androsaurs/androsaur-stand/references/phone-holder-two-piece/README.md

# Держатель из Body и 82mm

STL переданы владельцем из Загрузок 2026-10-27. Автор, лицензия и исходная
страница пока не сообщены. Размеры трактуются в миллиметрах.

Body: 105,6 × 28,5 × 30 мм. 82mm: 88 × 23,6 × 10 мм.
Оригинальные файлы сохранены без изменений. Детали построены параметрически кодом `../../cadpy/clip_holder.py`
(функции `body()` и `grip()`), форма взята по этим STL; прежние файлы FreeCAD удалены из рабочего дерева, они остались в истории git
(коммит 9d254f3).

Ось Z сборки направлена вдоль Body от нижнего упора вверх, X — поперёк, Y — вперёд к телефону. Поперечина центрирована по ширине
и расположена на Z 66,677–76,677 мм между задними направляющими Body (Z 66,5 и 76,854 мм), по уточняющему изображению владельца.
Физическая фиксация и усилие защёлки не проверены. Верхняя зубчатая деталь по указанию владельца не используется.

Телефонный габарит в модели 170 × 80 × 8,8 мм (`clip_holder.phone()`), нижней кромкой на упоре Body, спинкой к стойке.
