androsaurs/androsaur-stand/references/datasheets/README.md

# Компоненты текущей модели

Используется [MG996R и пользовательский STL](mg996r/README.md).
Не выбранные ранее сервоприводы и неопознанный габаритный серво удалены
из рабочего дерева. Их история сохранена в Git.
