androsaurs/androsaur-stand/references/datasheets/mg996r/README.md

# MG996R: источники и пользовательская модель

`user-model/MG996R_Servo_Model.stl` передан владельцем из Загрузок
2026-10-27 и сохранён без изменений. По нему построен габарит серво в `../../../cadpy/pantilt.py` (функция `servo()`; толщина корпуса уточнена обмером 20 мм).
SHA-256: `99eb0a1ad5ec43cabf3966861050f36cdcc39737a85430847066beaf03012544`.
Автор и лицензия файла не сообщены; автоматически применять к нему
лицензию проекта нельзя. Точный физический экземпляр ещё не обмерен.

`MG996R_Tower-Pro.pdf` — опубликованный паспорт с размерным эскизом,
сохранённый без изменений с
https://www.mysensors.org/dl/57c421ad4d04abe84cd93e17/design/MG996R_Tower-Pro.pdf.
SHA-256: `d925b93e0fcbdba07426cc257e6a4c1dee5bb7f3009138a596c4f7826f548434`.
Условия распространения в документе отдельно не установлены.
Официальная страница: https://towerpro.com.tw/product/mg996r/.
Размеры источников различаются; текущая компоновка основана на переданном STL.
