androsaurs/androsaur-stand/docs/electronics-checks.md

# Проверки электроники перед пайкой

**Коротко: что обязательно, а что только если не заработало.**

- Обязательно: HW-674 выставить на 5,0 В до подключения серво и ESP32 (раздел C); проверить полярность штекера адаптера (E1).
- Платы из коробки обычно работают как есть. PCM5102A (раздел A): сначала подключить и послушать, прозванивать перемычки только если звука нет или он искажён.
- Ключ Q1 (раздел B): проверяется функционально, 3,3 В на PWM включает зарядку.
- Уровень MUTE (раздел D) нужен только если захочется убрать щелчок при включении; MUTE в схеме не подключаем.

Составлено 2026-11-11. Схема: [`schematic.svg`](schematic.svg). Фото и данные плат — в пространстве мета-агента, `notes/electronics-refs/README.md`.
Каждую проверку делать до того, как плата попадёт в схему. Результат записывать в колонку «Результат» в этом файле.

Нужно: мультиметр (прозвонка, проверка диодов, постоянное напряжение), паяльник с оплёткой для снятия припоя, штангенциркуль.
Платы без питания, пока не сказано иное.

## Статус плат

| Плата | В руках? |
| --- | --- |
| PCM5102A (GY-PCM5102) | нет, приедет 2026-11-11 или 2026-11-12 |
| HW-532 (ключ Q1) | да |
| HW-674 (buck), TPA3118, CTP01, адаптер 12 В | уточнить |

## A. PCM5102A (когда приедет)

Сначала: подать 5 В на VIN и GND, BCK, LRCK, DIN от ESP32, выход LROUT на усилитель (тихий тон). Работает, значит остальное в этом разделе не нужно. Не работает или шумит — прозванивать, всё без питания:

Маркировке H/L у перемычек на плате не верить (по отзыву покупателя она перевёрнута). Ориентироваться только на прозвонку.
Режим прозвонки (значок звука): писк или около 0 Ом = соединено.

| № | Что делать | Должно быть | Результат | Если не так |
| --- | --- | --- | --- | --- |
| A1 | Щупы на SCK и GND (в ряду SCK, BCK, DIN, LRCK, GND, VIN) | звонится | | не звонится: припаять провод SCK → GND |
| A2 | XSMT и A3V3 | звонится (звук не заглушён) | | не звонится, а звонится XSMT с GND: перенести паяную перемычку на высокий уровень |
| A3 | FMT и GND | звонится (формат I2S) | | звонится с A3V3: перенести перемычку на GND |
| A4 | FLT и GND | звонится | | перенести перемычку |
| A5 | DEMP и GND | звонится | | перенести перемычку |
| A6 | VIN и A3V3 | **не** звонится (на плате есть стабилизатор) | | звонится: стабилизатора нет, VIN подавать 3,3 В, а не 5 В, и сказать мейн-агенту |

Перемычку переносят паяльником: убрать припой оплёткой с одной стороны площадки и посадить на другую. Потом прозвонить заново.

После того как A1–A6 в порядке, подать 5 В на VIN и GND (от лабораторного блока или шины 5 В стенда) и проверить:

| № | Что | Должно быть | Результат |
| --- | --- | --- | --- |
| A7 | Напряжение A3V3 относительно GND | около 3,3 В | |

## B. HW-532 (ключ Q1), модуль в руках

Подписи на плате (фото владельца): «+» (V+), «LOAD» (середина), «–» (GND). Проверить диодом (значок диода), без питания:

| № | Что делать | Должно быть | Результат |
| --- | --- | --- | --- |
| B1 | Красный щуп на «–», чёрный на LOAD | 0,4–0,7 В | |
| B2 | Красный на LOAD, чёрный на «–» | OL (обрыв) | |
| B3 | «+» относительно «–» и LOAD | не звонится | |

Если B1/B2 показали обратное, подписи на плате неверны: поменять «–» и LOAD местами в схеме и сообщить мейн-агенту.

Затем функциональный тест (нужен адаптер 12 В и модуль CTP01):
1. 12 В на «+» и «–» Q1 (через предохранитель 6,3 А или просто на кратковременное включение).
2. +IN CTP01 на 12 В, –IN CTP01 на LOAD.
3. На PWM и GND Q1 подать 3,3 В от ESP32 (вывод 3V3 и GND платы ESP32) и **заметить**, появилось ли 5 В на USB-A CTP01 (мультиметр на щупах USB).
4. Убрать 3,3 В с PWM: 5 В на USB должно пропасть.

| № | Что | Результат |
| --- | --- | --- |
| B4 | 3,3 В на PWM включает зарядку (5 В на USB есть) — да / нет | |
| B5 | Снять 3,3 В — зарядка выключилась — да / нет | |

Если включается наоборот (без сигнала есть 5 В), в прошивке инвертировать GPIO6. Если не включается совсем, подать 5 В на PWM (в описании модуль рассчитан на широкий диапазон) и сообщить мейн-агенту.

## C. HW-674 (buck 5 В для серво и ESP32)

1. Подать 12 В на IN, **ничего не подключать на выход**.
2. Вращать подстроечник Adj, пока на OUT+ относительно OUT– не будет **5,0 В**.
3. Только потом подключать ESP32 и серво.
4. Сфотографировать плату сверху и крупно маркировку чипа, прислать мейн-агенту (в описании XL4016E1, на фото XL4005).

| № | Что | Результат |
| --- | --- | --- |
| C1 | Выход выставлен на 5,0 В (записать точное значение) | |
| C2 | Маркировка чипа (по фото) | |

## D. TPA3118, уровень MUTE (необязательно)

Нужно только чтобы убрать щелчок при включении через GPIO18. Без MUTE усилитель работает.
Требуется тихий источник звука: телефон с кабелем 3,5 мм.

Громкость источника сначала на минимум. Динамик подключить к OUT+ и OUT–.
1. Подать 12 В на POWER+ и POWER–.
2. Измерить напряжение MUTE относительно GND без соединений: запомнить (0 В или несколько вольт).
3. Подать тихий звук на IN+ (сигнал), IN– на GND, убедиться, что звук идёт.
4. Замкнуть MUTE на GND — звук пропал или остался?
5. Убрать, потом соединить MUTE с 3,3 В от ESP32 — звук пропал или остался?

| № | Что | Результат |
| --- | --- | --- |
| D1 | Напряжение на MUTE без соединений | |
| D2 | MUTE на GND: звук пропал / остался | |
| D3 | MUTE на 3,3 В: звук пропал / остался | |

Вывод: тот уровень, при котором звук пропал, глушит. Результат сообщить мейн-агенту, он допишет схему и логику GPIO18.

## E. Общие и размеры

| № | Что | Результат |
| --- | --- | --- |
| E1 | Полярность штекера адаптера (центр «+») — мультиметром на выходе адаптера | |
| E2 | Напряжение адаптера без нагрузки | |
| E3 | Размеры плат штангенциркулем: TPA3118, PCM5102A, CTP01, HW-674, HW-532, ESP32 (длина, ширина, высота) | |
| E4 | Динамик FD92-1: диаметр окружности отверстий под винты | |

## F. Порядок первого включения (после A–E)

1. Собрать на столе по схеме, **без телефона и без динамика**.
2. Подать 12 В, замерить 5,0 В на шине серво и ESP32, 3,3 В на 3V3 ESP32, 12 В на POWER усилителя.
3. Прошить ESP32 (USB-C), питание 5 В от HW-674 в это время отключить.
4. Проверить серво на малых углах и без механики.
5. Задать в прошивке потолок громкости около 15% полной шкалы PCM5102A **до** первого звука.
6. Подключить динамик, проиграть тихий тон.
7. Подключить телефон через CTP01 и включить Q1.

## G. Собранная подставка: проверка сервоприводов — 2026-11-14

Управление проверено напрямую с компьютера по pinned HTTPS, delegated hub key,
на штатной прошивке `0.7.0-servo-control`. Телефон в командах движения не участвует.

| Проверка | Результат |
| --- | --- |
| Середина: оба канала1500мкс/50Гц на5с | Владелец подтвердил: серво дёрнулось и встало в середину |
| Pan, GPIO4:1475 →1500 →1525 →1500мкс | Владелец подтвердил движение влево-вправо |
| Tilt, GPIO5:1475 →1500 →1525 →1500мкс | Владелец подтвердил движение вверх-вниз |
| Финал | Оба канала получили1500мкс, затем PWM выключен; остановка подтверждена HTTPS |

Каждая команда движения действовала1с; оси проверялись последовательно.
Это подтверждение работы обеих осей в малом диапазоне, не калибровка углов,
крайних положений, направлений знака или способности питания выдерживать упор.
Границы1450..1550мкс пока ограничивают ручное управление; автослежение выключено.
Выход HW-674 мультиметром и физическое переключение зарядки в этом прогоне
не проверялись; строки предыдущих таблиц не считать автоматически заполненными.

## Расхождения с electronics.md

[`electronics.md`](electronics.md) пока не обновлён: там питание PCM5102A 3,3 В (на самом деле 5 В на VIN, по схеме macsbug), серво и ESP32 раздельные ступени (решение владельца 2026-11-11: общий buck 5 В), подстроечный резистор и резисторы 220 Ом на сигнале серво (убраны), блока питания 6 В нет (серво на 5 В).
