androsaurs/androsaur-stand/docs/electronics.md

# Электроника

Состав, питание и подключение. Размеры плат в модели оценочные (по фото продавцов), кроме габаритов; перед печатью их надо
перемерить штангенциркулем и поправить в [`cadpy/amp.py`](../cadpy/amp.py), [`esp32.py`](../cadpy/esp32.py), [`speaker.py`](../cadpy/speaker.py).

| Узел | Выбор | Примечание |
| --- | --- | --- |
| Контроллер | ESP32-S3 N16R8 DevKitC-1 WROOM-1, плата 28 × 57, с антенной 64 мм | Два USB-C. На модуле с PSRAM октал заняты GPIO35–37 |
| Динамик | FD92-1, 4 Ом, 10 Вт, фланец Ø92, магнит Ø50 × 22, высота 42, диффузор Ø75 | Четыре отверстия Ø4 во фланце; диаметр их окружности (82 мм) принят, не измерен |
| ЦАП | PCM5102A, плата 17 × 32, выход на разъём 3,5 мм | I2S от ESP32, питание 3,3 В |
| Усилитель | Моно TPA3118, плата 46,5 × 35, четыре отверстия | Вход аналоговый, есть вход MUTE |
| Серво | 2 × MG996R 180° | 4,8–7,2 В, до 2,5 А каждый при упоре |
| Блок питания (buck 6 В) | Куплен; в описании продавца «XL4016E1, вход 4–38 В, выход 1,25–37 В, 8 А», на фото модуль HW-674 (маркировка XL4005) 60 × 38 × 26 | Какой чип на самом деле, пока не известно (описание и фото расходятся). Модель сделана по фото. Выход настроить на 6,0 В мультиметром до подключения серво |

## Питание

Один адаптер 12 В 5–6 А (штекер 5,5 × 2,1), дальше отдельные ступени:

```
Адаптер 12 В ──[предохранитель 6,3 А]──┬── усилитель TPA3118 (12 В напрямую)
                                        ├── buck 6 В ≥ 5 А ── два MG996R
                                        ├── buck 5 В 3 А ──── ESP32 (5V); от её 3V3 питается ЦАП
                                        └── зарядка 5 В 2–3 А ─ USB для телефона
```

Земли сводятся в одной точке. Питание серво отдельным преобразователем, иначе броски тока портят звук и перезагружают ESP32.

Бюджет (пик, оценка): серво до 30 Вт, усилитель около 13 Вт при 10 Вт на выходе, ESP32 с ЦАП около 2 Вт, зарядка телефона около 11 Вт.
Итого до 57 Вт при одновременном упоре обоих серво; на практике хватает 12 В 5 А.

Что искать в магазине:

- Блок питания «12 В 5 А 60 Вт, 5,5 × 2,1»; смотреть отзывы, реальная мощность часто занижена.
- Buck на серво: «DC-DC понижающий XL4015 5A CC/CV», выход настраивается, лучше с радиатором. LM2596 на 3 А мало.
  Модуль на XL4005 (HW-674, 60 × 38 × 26) без ограничения тока и тесный по высоте; XL4016 (65 × 47 × 23,5) в корпус не помещается.
- Buck на ESP32: «MP1584EN 3A».
- Зарядка телефона: «понижающий 12 В → 5 В 3 А с USB» или модуль USB-C PD с входом 12 В.
- Мелочи: предохранитель, электролит 1000 мкФ на 10–16 В на шине серво, панельное гнездо 5,5 × 2,1, разъёмы JST/XT30.
- Выход buck на серво настроить мультиметром на 6,0 В **до подключения серво**, MG996R выше 7,2 В выходит из строя.

## Усилитель и ЦАП: громкость обязательно ограничить

PCM5102A на полной шкале даёт около 2 В действующего значения, усилитель без регулировки усиливает примерно в 20 раз.
До 10 Вт на 4 Ом хватает входа около 0,3 В. Значит:

- потолок громкости в прошивке около **15% полной шкалы** (примерно −16 дБ), точное значение подобрать на слух и мультиметром;
- на полной шкале усилитель уходит в клиппинг и отдаёт динамику больше 10 Вт, динамик это не переживёт;
- на вход усилителя рекомендуется поставить делитель из двух резисторов или подстроечный резистор, чтобы защита не зависела от прошивки;
- питать усилитель выше 12 В нельзя, динамик 10 Вт.

Подключение PCM5102A: SCK замкнуть на землю (на многих платах перемычка на обратной стороне; сверить с описанием продавца),
выводы BCK, DIN, LCK — линии I2S ESP32. Сигнал на усилитель с гнезда 3,5 мм или с площадок L/G, моно: левый канал.
MUTE усилителя — на ногу ESP32, чтобы глушить усилитель при включении (нет щелчков).

## Управление серво

- ШИМ 50 Гц, импульс 500–2500 мкс на 0–180°. Аппаратный ШИМ (LEDC), две свободные ноги (например GPIO4 и 5), не 0, 3, 45, 46 и не 35–37.
- Сигнал 3,3 В MG996R обычно принимает; при сбоях — преобразователь уровней. Резистор 220–470 Ом последовательно.
- Серво не знают своего положения: при включении подавать последнее известное положение или плавно подводить.
  Движение с разгоном и торможением, чтобы не просаживать питание.
- Углы по модели: наклон −2…100°, поворот 180°.
- Провода идут через полость ножки и два окна на фасаде ножки (зарядка и моторы).

## Что не решено

USB ESP32 находится внутри закрытого корпуса (прошивка — со снятой верхней половиной), антенна смотрит в стенку корпуса,
рядом блок питания и усилитель: возможны помехи. См. [open-issues.md](open-issues.md).
