androsaurs/androsaur-stand/docs/project-organization.md

# Организация моделей

Актуальная структура после перехода на детали BRep, 2026-11-02. В рабочем дереве одна конструкция.

```text
cad/
├── components/                 # покупные изделия и габариты
│   ├── mg996r-brep/mg996r-brep.FCStd  # BRep-габарит, один источник, два экземпляра
│   ├── mg996r/mg996r.FCStd      # пользовательская сетка: источник и эталон для BRep
│   └── phone/phone.FCStd
├── parts/                      # изготовляемые детали
│   ├── base/base.FCStd
│   ├── pan-carrier-brep/pan-carrier-brep.FCStd
│   ├── servo-side-brep/servo-side-brep.FCStd
│   ├── shaft-side-brep/shaft-side-brep.FCStd
│   ├── tilt-platform-brep/tilt-platform-brep.FCStd
│   ├── tilt-horn/tilt-horn.FCStd
│   ├── pan-horn/pan-horn.FCStd
│   ├── phone-holder/phone-holder.FCStd
│   └── phone-holder-body, phone-grip-82mm, phone-adapter-plate   # держатель из двух деталей
└── assemblies/
    ├── pan-tilt-brep.FCStd      # механизм
    ├── phone-holder.FCStd       # держатель и телефон
    ├── phone-holder-two-piece.FCStd  # держатель из двух деталей (в stand не установлен)
    └── stand.FCStd              # общая компоновка
exports/                        # снимки для обмена и изготовления
references/                     # оригиналы сторонних материалов
docs/                           # текущая документация
scripts/                        # проверка и построение (build-*.FCMacro)
```

Деталь — один документ. Геометрию редактировать в нём. Покупное изделие
использовать через повторные App::Link; оба MG996R ссылаются на один объект.
Верхняя площадка — одна деталь; внутри её документа сохранены четыре
геометрических элемента, уже в принятых относительных положениях.

Подсборка — отдельный документ с корневым App::Part `Module`. Он содержит
ссылки на детали и именованные опорные системы координат. Подсборку можно
открывать, изучать и изменять независимо. Внешние модули не зависят от неё
геометрией: связь идёт через опорный интерфейс.

Общая stand.FCStd содержит только экземпляры модулей. PhoneHolder.Placement
вычисляется через `PanTilt.Placement * PanTilt.PhoneInterface`. Поэтому держатель
следует за механизмом, а перенос всей подставки не требует двигать каждую деталь.

Корпус электроники пока не спроектирован. Для него создать отдельные детали
в parts/ и сборку electronics-case.FCStd с корневым Module и MountInterface.
Затем добавить ссылку в stand.FCStd и совместить интерфейс корпуса с
BaseInterface механизма. До этого пустые заготовки и условные объёмы не добавлять.

Старые варианты и промежуточные экспорты удалены. История — Git,
`before-modular-layout`, а не каталоги old/final/v2. Экспорты не являются источником
геометрии и обновляются после изменения FCStd. Проверенный печатный комплект
пока не выпускался.

Замена 2026-11-02: сеточный механизм `pan-tilt.FCStd` и сеточные детали заменены на BRep
(`docs/pan-tilt-brep.md`). Старое состояние — коммит `a86b0bd` в Git. Эксперименты по превращению
STL в BRep перенесены вне репозитория в `/mnt/fastdata/hram/archive/androsaur-stand-brep-experiments-20261102`.
