androsaurs/androsaur-stand/references/pan-tilt-1941574/README.md

# Pan and Tilt for Standard Servo — 1941574

Архив передан владельцем 2026-10-26 из Загрузок, сохранён без изменений.
Автор: micromet. Источник по README архива:
https://www.thingiverse.com/thing:1941574.
Лицензия по LICENSE.txt: Creative Commons Attribution Share Alike;
версия в приложенном тексте не указана. Сторонние материалы сохраняют
собственные условия, лицензия Androsaur Stand их не заменяет.

SHA-256 архива: `7ca2dae743f5629b68f92221c4c787d6d7f99939f9b440355d1fad99935869af`.
`original/` — используемые материалы распакованного архива; `scad-rev/` —
используемые исходники из вложенного `PanTilt_std_SCAD_rev.zip`.
Неиспользуемый держатель ИК-датчика удалён из распакованного дерева;
полный оригинальный ZIP сохранён. Оставшиеся STL и SCAD не изменялись.

Авторские фотографии: original/images/Assem1.jpg, Assem2.jpg, explod.jpg.
Исходники указывают HobbyKing15269. Принятая владельцем компоновка с MG996R
собрана кодом в `../../cadpy/`; реальные посадки и крепёж
ещё не проверены. Геометрия автора и производные сохраняют его CC BY-SA.
