androsaurs/androsaur-stand/docs/requirements.md

# Требования

Актуализировано по указаниям владельца, 2026-11-04. Принятые ранее положения о механизме сохранены.

## Подставка

- Два серво MG996R 180° (поворот и наклон), по STL владельца (габарит, не обмеренный экземпляр).
- Телефон Xiaomi Redmi 12 без чехла: 168,6 × 76,3 × 9,0 мм (толщина по замеру владельца), ось наклона посередине высоты. Двухдетальный держатель (спинка + захват 77,3 мм между стенками).
- Кнопки телефона на правой боковой грани, на высоте около 85 мм от нижнего края (замер владельца, нижний край нижней кнопки не уточнён). Захват держит телефон на высоте 59,7–69,7 мм от нижнего края: центр кнопок вне зоны захвата; если нижняя кнопка начинается ниже 70 мм, нужно окно в боковой стенке захвата.
- Зарядка Type-C снизу: место под штекер и кабель, не упирается в основание при наклоне вперёд. Ножка достаточно высокая
  (104 мм), чтобы кабель дошёл до окна на ножке.
- Ножка полая для проводов, два окна со стороны телефона (зарядка и моторы).
- Основание **не стоит на корпусе, а висит под крышкой**, ножка выходит вверх через отверстие в крышке. В верхней стороне
  крышки нет отверстий под винты подставки.

## Корпус

- Размер 125 × 125 мм (высота выбрана 70), **разборный из двух частей**, шов горизонтальный посередине, винты снизу.
- Содержимое: динамик FD92-1 (4 Ом, 10 Вт), ESP32-S3, усилитель, ЦАП, блок питания, питание и зарядка телефона.
- Динамик в углу корпуса, на проставках над дном, в полу решётка. Внутри полка на ножках с отверстием под магнит динамика.
- Полка с плоским верхом: печатается плитой вниз; платы на ней и под ней.
- Вход питания на задней стенке нижней половины, вентиляция на задних стенках обеих половин, щели в полке напротив для сквозной тяги.
- Корпус на отдельных ножках, которые крепятся к нему отдельно и не входят в деталь корпуса.
- Ножки корпуса не у самого края, симметрично.

## Электроника и питание

- Адаптер питания 12 В, гнездо 5,5 × 2,1 мм (владелец купил адаптер).
- Усилитель на 10–20 Вт, питание 8–24 В, цифровой звук с ESP32 по I2S через ЦАП (куплены PCM5102A и TPA3118 мономодуль).
- Серво питаются отдельным понижающим преобразователем на 6 В.
- Блок питания: подходящий модуль не выбран; в корпусе должно быть место, габарит ~51 × 26 × 14 мм (XL4015) подходит.

## Изготовление

- Пробная печать PLA на Flying Bear Ghost6, **без поддержек** там, где это возможно.
- Проверка пересечений в диапазоне движения (наклон −2…100°, поворот) — обязательная при любом изменении геометрии.
