androsaurs/androsaur-stand/docs/fasteners.md

# Крепёж

Номенклатура: три длины M3 (6, 8 и 12 мм) и один M4 (динамик). Винты из комплекта серво не используются: отверстия под них в
лотке и в площадке переделаны под M3. Длины проверены по модели: глубина отверстий, вход в пластик, головка в углублении.
Резьба нарезается самим винтом в отверстия Ø2,6 (PLA); для частой разборки можно поставить латунные вставки M3 (диаметр отверстий
придётся увеличить до 4–4,2 мм).

Головка круглая или полукруглая (ISO 7380 Ø5,7, DIN 7985 Ø5,6, DIN 912 Ø5,5): она должна проходить в углубления Ø6,4.

| Узел | Шт | Крепёж | Как работает |
| --- | --- | --- | --- |
| Усилитель к стойкам под полкой | 4 | M3×6 | Через плату в пилоты стоек, винт заходит на 4,4 мм |
| Ножки полки | 3 | M3×6 | Снизу через дно, головка в углублении Ø6,4 × 2,5 мм, в ножку входит 4,5 мм |
| Ножки корпуса | 4 | M3×6 | Изнутри в углублении Ø6,4 × 2,5 мм через пол в пилот ножки, входит 4,5 мм |
| Подошва подставки к крышке | 4 | M3×8 (ISO 7380) + печатная прижимная шайба | Головка снизу под шайбой толщиной 3 мм; винт входит в глухой пилот пенька на 5 мм, до дна остаётся 1 мм |
| Стяжка половин корпуса | 4 | M3×12 | Снизу в тоннель Ø6,4 глубиной 31 мм в нижней стойке, в пилот верхней стойки входит 8 мм |
| Спинка держателя к площадке | 4 | M3×8 | Со стороны телефона: головка в углублении Ø6,4 × 3 мм спинки, винт входит в глухой пилот Ø2,6 × 4,5 мм площадки (плита 6 мм), 4 мм в зацеплении; гаек нет. Телефон надо вынуть, чтобы добраться до головок |
| Нижнее серво к лотку | 4 | M3×8 | Снизу вверх через ухо серво (Ø4,2) в пилот Ø2,6 лотка, входит 5 мм, конец не выходит над плитой |
| Верхнее серво к площадке | 3 | M3×8 | С верха уха серво в блок площадки (пилот Ø2,6 вдоль оси Y), входит 5 мм; в четвёртом углу под ухом нет материала (низкий блок), там винта нет |
| Боковины к лотку | 4 | M3×8 | Через отверстие Ø3 боковины в отверстие Ø2,6 лотка, входит 5 мм |
| Блок питания HW-674 к полке | 4 | M3×8 | Сверху: головка на плате, под ней печатная втулка 3 мм, дальше плита полки 3 мм и столбик под ней 2,5 мм; входит 3,4 мм, конец остаётся в столбике |
| Динамик во фланец | 4 | M4×8 | Сверху через фланец в стойки Ø9 × 5 с пилотом Ø3,4; при отверстиях во фланце Ø4,0 — M3,5×8 |

## Что купить

С запасом около 25%:

| Позиция | Нужно | Купить |
| --- | --- | --- |
| M3×6 | 11 | 15 |
| M3×8 | 23 | 30 |
| M3×12 | 4 | 6 |
| M4×8 (или M3,5×8) | 4 | 6 |

Для крепления подставки напечатать **4 шайбы `stand_washer` Ø18 × 3 мм**:
сквозное отверстие Ø3,4, выборка Ø9,8 × 0,5 мм на стороне подошвы. Шайба перекрывает
отверстие подошвы Ø9,4; выборка даёт 0,5 мм до торца пенька, чтобы затяжка прижимала
подошву. Плоская сторона шайбы обращена к головке винта, выборка — к `base`.
Печатать плоской стороной на стол, без поддержек; требуется 4 экземпляра одного STL.

Сборочные координаты: шайбы Z2–5, подошва Z5–9, головки винтов Z0,35–2, стержни Z2–10.
Вход в пеньки начинается на Z5, дно пилотов — Z11. Это винты в прежние пилоты Ø2,6,
с самонарезанием резьбы в PLA, а не сквозное соединение с гайками. Упрощённый стержень Ø3
в модели пересекает пилот Ø2,6 на 8,264 мм³ для каждого винта — это ожидаемый объём резьбового зацепления.

## Что не определено

- Качалки серво (круглая и на верхнем серво) и их крепёж из комплекта серво в модели не размещены.
- Положение крепёжных отверстий блока питания HW-674 (принято: отступ 3,5 мм от углов), измерить на плате. Печатные втулки 3 мм (4 шт) входят в крепление.
- Диаметр отверстий во фланце динамика (принят Ø4,0, нужно измерить): от него зависит M4 или M3,5.

## Почему не одна длина

Для подставки M3×8 даёт 5 мм захода после шайбы 3 мм. M3×6 дал бы 3 мм захода,
а M3×10 потребовал бы 7 мм при глубине пилота 6 мм и упёрся бы в дно. Поэтому выбран M3×8.
Стяжка корпуса проходит через 31 мм тоннеля и заходит в пилот на 8 мм, ей нужен M3×12.
