androsaurs/androsaur-stand/docs/interfaces.md

# Системы координат и опорные точки

Единицы — мм. **Мировая система модели:** Z вверх, фасад (сторона телефона) +X, ось наклона вдоль Y.
Начало (0, 0, 0) сохраняет исходную систему сборки; после подгонки к крышке низ подошвы находится на Z5.
Ось ножки — в точке (42,5; 42,5), верх цилиндра остаётся на Z104.

| Что | Положение |
| --- | --- |
| Низ подошвы подставки | z = 5 |
| Верх подошвы | z = 9 |
| Торцы четырёх пеньков крышки | z = 5 |
| Низ потолка корпуса | z = 9 |
| Верх крышки | z = 12 |
| Шов между половинами | z = −23 |
| Низ корпуса | z = −58 |
| Низ ножек корпуса | z = −66 |

Корпус `enclosure.py` строится в собственной системе (начало в центре корпуса по X и Y, Z от низа дна), а в сборке ставится сдвигом
`Pos(42,5; 42,5; −58)` (см. `to_box` в `assemble`). Там же сказано, где какая сторона.
Положение корпуса фиксируется `BOX_Z0`, поэтому изменение толщины потолка не перемещает корпус и его содержимое.
`BASE_Z0` вычисляется по низу потолка: подошва Z5–9 прилегает к крышке на Z9, пеньки Z5–9 входят в неё на все 4 мм.
Цилиндр укорочен снизу с 104 до 99 мм; высоты его верха, окон, посадки серво и механизма не изменились.

## Платформа и телефон

Система платформы: `x_p` вдоль высоты телефона, `y_p` поперёк и вдоль оси наклона, `z_p` — толщина; телефон со стороны −`z_p`.
Наклон 0° — площадка горизонтально лицом вверх; 90° — вертикально лицом к +X; больше 90° — наклон вперёд. Ось наклона проходит
по середине высоты телефона, за ним, а не внутри толщины. Ось поворота — вертикальная ось ножки.

## Держатель

Держатель строится в системе X поперёк телефона, Y к телефону, Z вдоль высоты и ставится на платформу `Location(Plane(...))` в
`assemble`. Задняя плоскость спинки прилегает к площадке; `HOLDER_SLIDE = −8` сдвигает его вдоль высоты телефона.

## Подсборки

Всё собирается кодом: `assemble()` кладёт каждую деталь по явным координатам. Новые модули добавлять новой функцией и
ставить на корпус или на основание по этим координатам.
