androsaurs/androsaur-stand/docs/pan-tilt-brep.md

# Механизм на деталях BRep (pan-tilt-brep)

`cad/assemblies/pan-tilt-brep.FCStd` — поворотно-наклонный механизм общей сборки. С 2026-11-02 он
заменил сеточный `pan-tilt.FCStd`: четыре детали micromet / Thingiverse 1941574 построены в BRep по SCAD
из архива, серво MG996R заменено BRep-габаритом. `stand.FCStd` ссылается на этот модуль, положения
механизма и держателя при переключении не изменились (разница 0,000000). Старое состояние — коммит `a86b0bd`.

## Состав

| Деталь | Файл | Источник |
| --- | --- | --- |
| Крепление нижнего серво | parts/pan-carrier-brep | PanMount7.scad |
| Боковина со стороны качалки | parts/servo-side-brep | sideplateservo_std.scad |
| Боковина с выступом | parts/shaft-side-brep | sideplateshaft_std.scad |
| Площадка наклона | parts/tilt-platform-brep | tiltservomount_std.scad |
| Серво MG996R (2 экземпляра) | components/mg996r-brep | замеры components/mg996r |

Без изменений из прежней модели: `base` (удлинённая полая ножка), `pan-horn`, `tilt-horn`. Площадка ИК-датчика
не включена. Структура модуля: `Module`, группы Fixed/Pan/Tilt, `BaseInterface`, `PhoneInterface`.
Детали строят `scripts/build-brep-parts.FCMacro` и `scripts/build-mg996r-brep.FCMacro`;
существующие файлы они не перезаписывают.

## Допущения

- Блоки серво площадки, их рёбра и отверстия под уши сдвинуты на 1,3151 мм вдоль оси Y площадки
  (`SERVO_MOUNT_SHIFT_Y`). Это принятая подгонка под MG996R: нижняя грань ушей серво лежит на y = −10,697 мм,
  грань блока — на −10,685 мм. Какие элементы SCAD входят в сдвигаемую группу, выбрано по смыслу.
- Положения серво взяты из принятой модели без изменений.
- Сетка MG996R несвязная (107 компонентов, самопересечения), у ушей открытые пазы вместо отверстий.
  BRep-габарит: корпус 19×40, уши 54×2,5 с отверстиями Ø4 (шаг 49,5×10), бобышка Ø13, шлиц Ø5,6, кабель Ø3.
  Не моделируются рёбра на ушах, штырёк 3×4, кольцо вокруг кабеля, углубления крышки.
  Положение отверстий — номинальная схема MG996R, не измерение.

## Проверено (расчёт во FreeCAD)

- Объёмы деталей совпадают с экспериментальной сборкой до 0,001 мм³; тела валидны, по одному solid.
- Положения всех девяти ссылок и групп совпали с принятой моделью (0,000000 мм, 0,000000°).
- BRep-габарит серво: 321 из 361 вершины сетки вне него лежат в пределах 0,05 мм, остальные до 0,3 мм, кроме
  пропущенных кольца кабеля (до 1,0 мм) и штырька (0,31 мм). Обратное направление (где BRep выступает
  за сетку) не измерялось.
- Нижнее серво: ошибка отверстий лотка 0,005 мм, ось вала на 0,015 мм от оси лотка.
- Верхнее серво: ошибки отверстий блоков 0,094 и 0,434 мм (шаг 49,5 мм против 49 мм), уши отстоят от грани
  блока на 0,012 мм, вал смещён от оси штифта на 0,46 мм.
- Пересечения, 7 деталей BRep, 21 пара: нет. Касания: Base–качалка, лоток–боковины.
- Пересечения серво: верхнее — нет (платформа 0,012 мм, ServoSide 0,003 мм, вставка 0,14 мм).
  **Нижнее входит в потолок кармана лотка: 257 мм³ по BRep (верхняя оценка, крышка в BRep сплошная),
  по сетке до 0,7 мм.** Причина: корпус MG996R выше стандартного серво примерно на 0,8 мм, карман лотка
  заканчивается на z = 8,0 мм. Лоток не менялся, решение за владельцем.
- Движение, пересечений нет: поворот −90°, −45°, 0°, +45°, +90° при нулевом наклоне; наклон −30°, −15°, 0°,
  +15°, +30° при нулевом повороте. Зазор платформы до корпуса нижнего серво: 18,4 мм при −30°, 10,0 мм при 0°,
  **1,69 мм при +30°** (дальше столкновение вероятно, предел не искали). До Base при +30° — 29,8 мм.

## Не проверено

- Сочетания поворота и наклона, точные пределы наклона, держатель с телефоном в движении.
- Путь кабеля, шлицы, крепёж, нагрузки, печать.
- Поведение BRep-серво по отношению к исходной сетке там, где BRep выступает за неё.
