androsaurs/androsaur-stand/docs/img/mechanism-tilt0.png

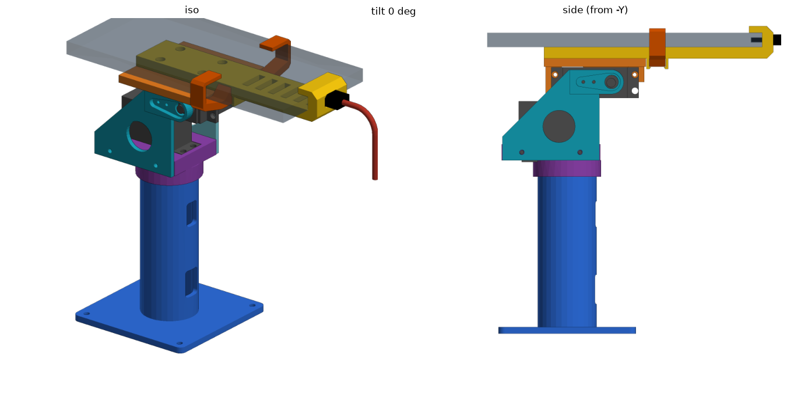
docs/img/mechanism-tilt0.png
