androsaurs/androsaur-stand/docs/img/mechanism-tilt45.png

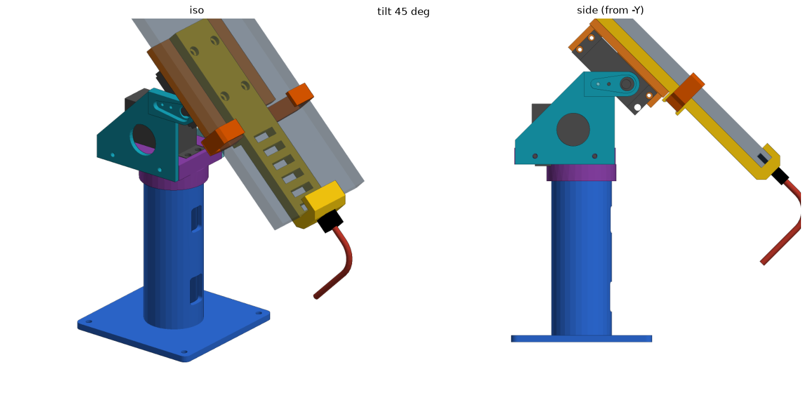
docs/img/mechanism-tilt45.png
