androsaurs/androsaur-stand/docs/img/power-jack-drawing.png

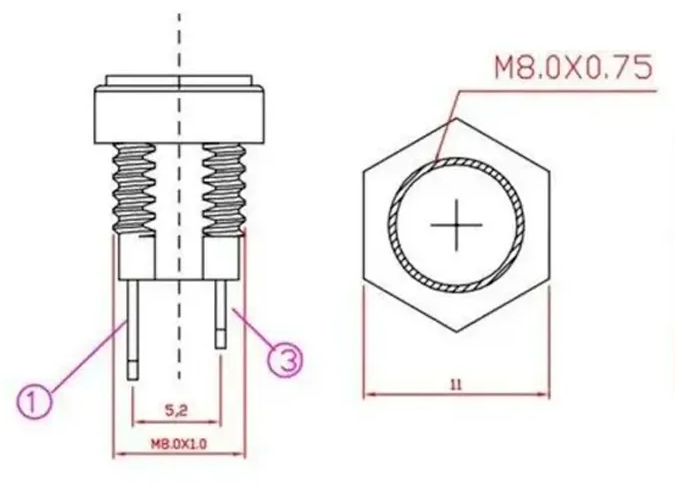
docs/img/power-jack-drawing.png
