androsaurs/androsaur-stand/references/1941574-fresh-20261027/images/834c1b2ab8570df11cbdad39efb2c1d5.png

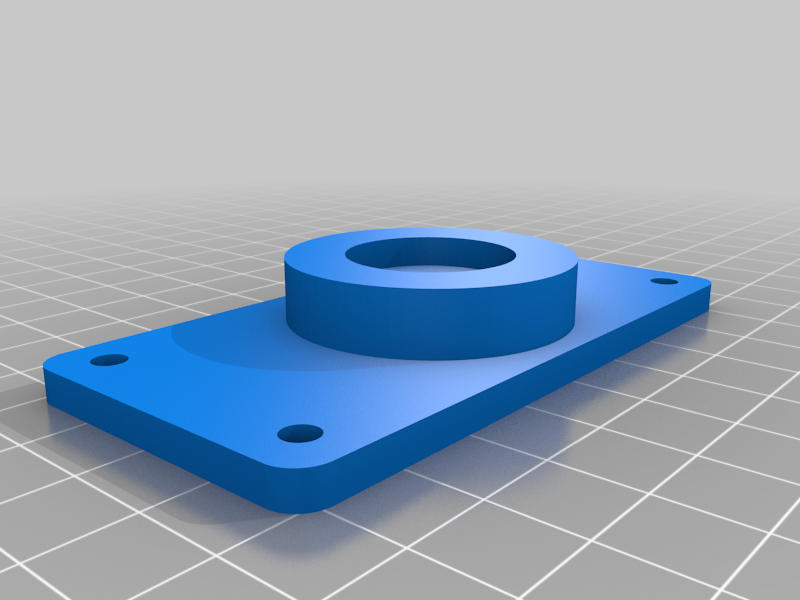
references/1941574-fresh-20261027/images/834c1b2ab8570df11cbdad39efb2c1d5.png
