androsaurs/androsaur-stand/references/1941574-fresh-20261027/images/878f043e9cf753a4e5998eb0beb1df78.png

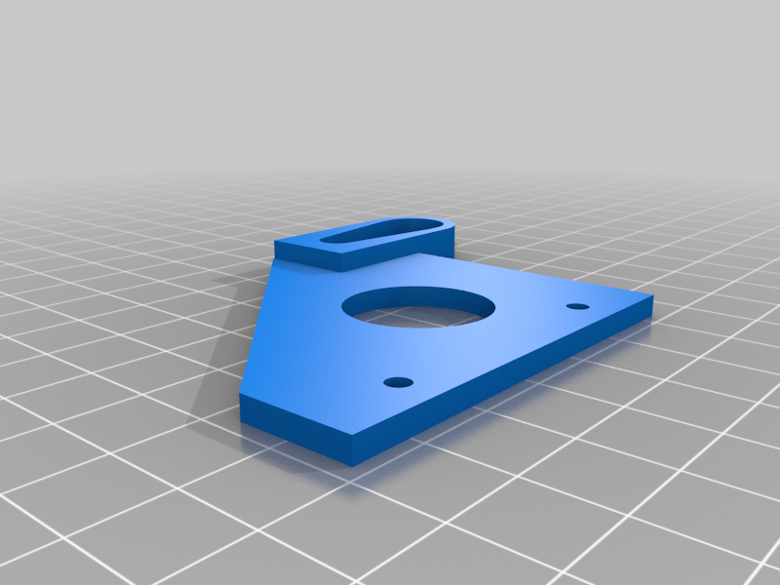
references/1941574-fresh-20261027/images/878f043e9cf753a4e5998eb0beb1df78.png
