androsaurs/androsaur-stand/references/1941574-fresh-20261027/images/520617ca388473ef5005c774b7b16fb1.png

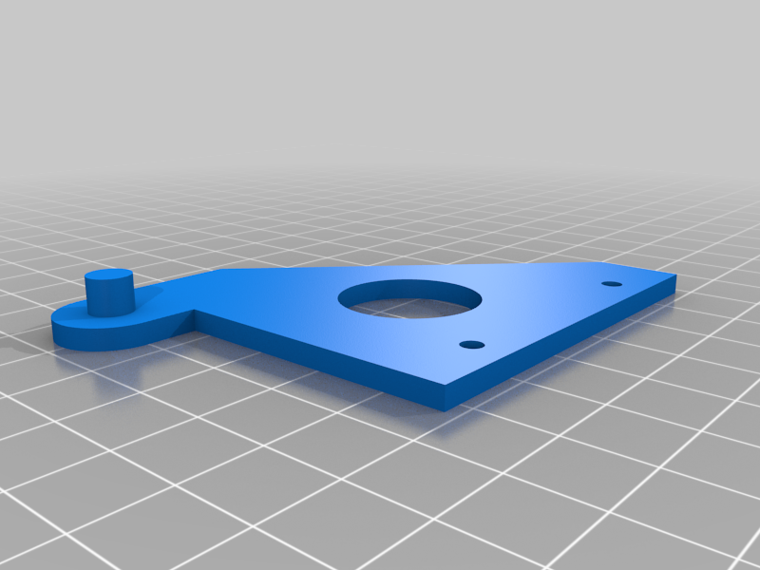
references/1941574-fresh-20261027/images/520617ca388473ef5005c774b7b16fb1.png
