androsaurs/androsaur-stand/references/1941574-fresh-20261027/images/18764812d7d0b451ea0a2450d63cde3c.png

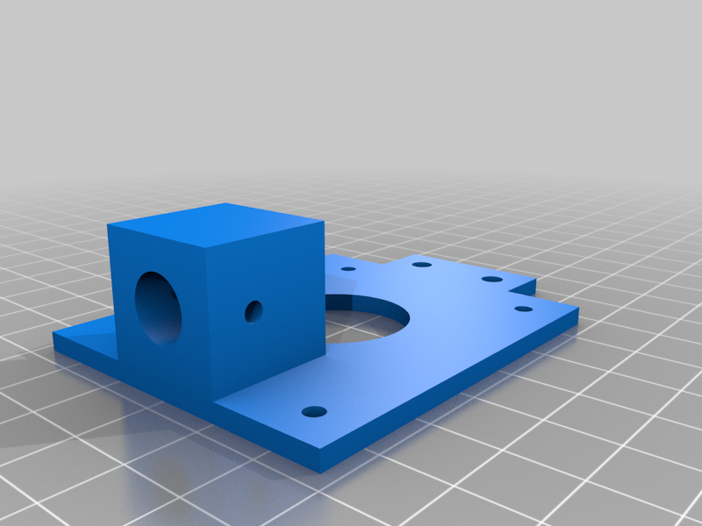
references/1941574-fresh-20261027/images/18764812d7d0b451ea0a2450d63cde3c.png
