androsaurs/androsaur-stand/references/1941574-fresh-20261027/images/Assem1.jpg

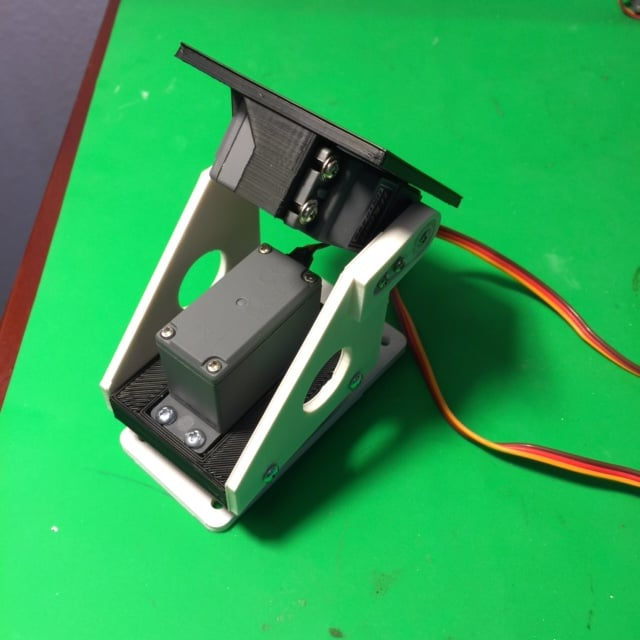
references/1941574-fresh-20261027/images/Assem1.jpg
