androsaurs/androsaur-stand/references/1941574-fresh-20261027/images/cccd069f99a9c03c0258334f676bf5a1.png

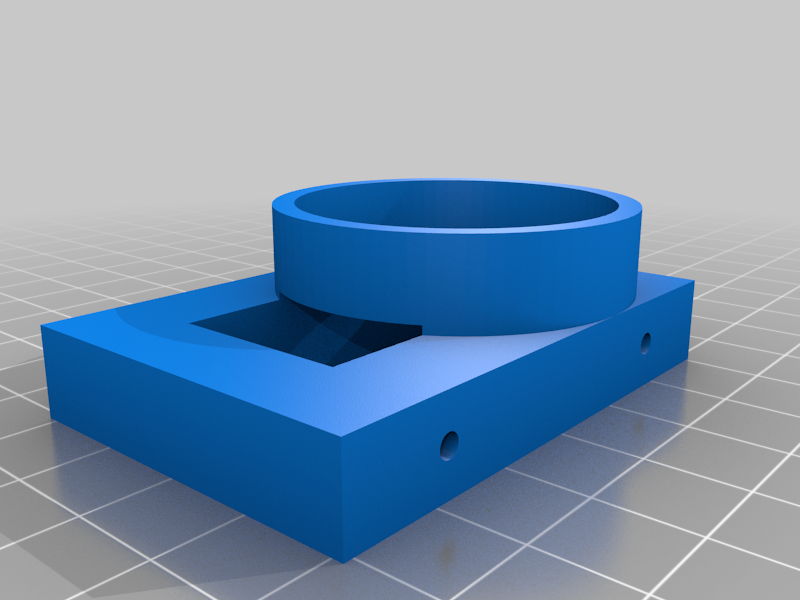
references/1941574-fresh-20261027/images/cccd069f99a9c03c0258334f676bf5a1.png
