androsaurs/androsaur-stand/references/1941574-fresh-20261027/images/ec95f7fee5eaacb880e60dee57f20235.png

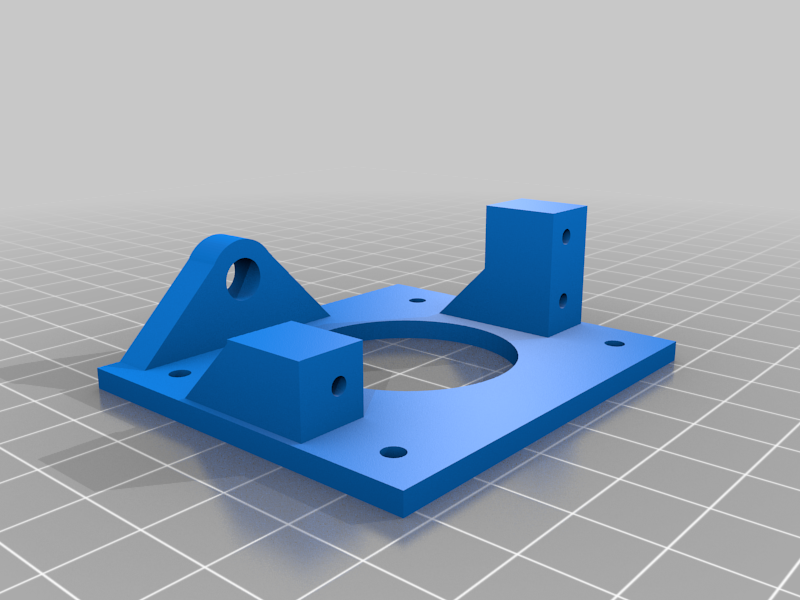
references/1941574-fresh-20261027/images/ec95f7fee5eaacb880e60dee57f20235.png
