androsaurs/androsaur-stand/references/1941574-fresh-20261027/images/explod.jpg

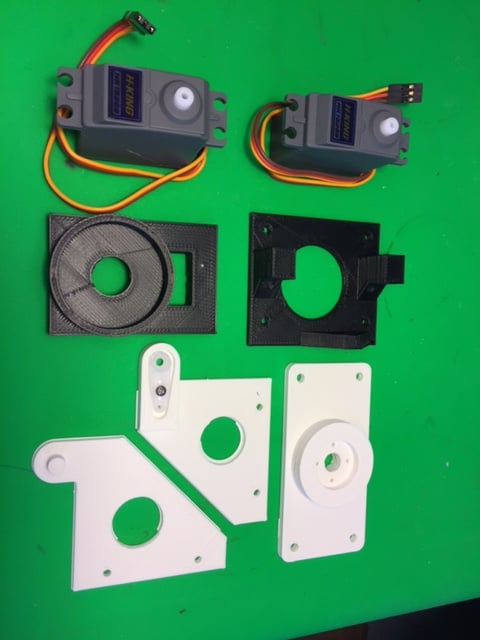
references/1941574-fresh-20261027/images/explod.jpg
