androsaurs/androsaur-stand/docs/bom.csv

part_id | quantity | kind | status | notes
base | 1 | printed | model | подошва 85x85, ножка Ø36,4, полость
stand_washer | 4 | printed | model | прижимные шайбы Ø18x3, отверстие Ø3,4, выборка Ø9,8x0,5 со стороны base
carrier | 1 | printed | model | лоток нижнего серво
plate_horn | 1 | printed | model | боковина со стороны качалки
plate_shaft | 1 | printed | model | боковина с выступом
platform | 1 | printed | model | площадка наклона, 5 мм со стороны держателя
body | 1 | printed | model | спинка держателя
grip | 1 | printed | model | захват 82 мм
box_lower | 1 | printed | model | нижняя половина корпуса, дном вниз
box_upper | 1 | printed | model | верхняя половина, потолком вниз
shelf | 1 | printed | model | полка, плитой вниз, верх плоский
foot | 4 | printed | model | ножки корпуса Ø14x8, винт M3 изнутри
втулка под блок питания 3 мм | 4 | printed | model | Ø7 x 3, отверстие Ø3,4
MG996R | 2 | purchased | chosen | серво 180°, габарит по STL владельца
FD92-1 | 1 | purchased | chosen | динамик 4 Ом 10 Вт, фланец Ø92, магнит Ø50x22, высота 42
ESP32-S3 N16R8 DevKitC-1 | 1 | purchased | chosen | плата 28x57, антенна до 64
PCM5102A | 1 | purchased | chosen | ЦАП, плата 17x32, I2S
TPA3118 моно | 1 | purchased | chosen | усилитель, плата 46,5x35, питание 8-24 В
адаптер 12 В 5-6 А, 5,5x2,1 | 1 | purchased | chosen | владелец купил
гнездо питания 5,5x2,1 панельное | 1 | purchased | bought | по чертежу резьба M8x0,75 (на чертеже и M8x1,0), гайка шестигранная 11 мм под ключ, два вывода (1 и 3) через 5,2 мм; по замеру владельца резьба Ø7,6; отверстие в стенке Ø8,0; чертёж docs/img/power-jack-drawing.png
buck 6 В XL4005 HW-674 (куплен) | 1 | purchased | chosen | 60x38x26, питание серво; реально 3-4 А, без ограничения тока
buck 5 В 3 А (MP1584EN) | 1 | purchased | not-chosen | питание ESP32
зарядка телефона 5 В 2-3 А | 1 | purchased | not-chosen | USB от 12 В
предохранитель 5 А и 6,3 А | 2 | purchased | not-chosen
электролит 1000 мкФ 10-16 В | 1 | purchased | not-chosen | на шине серво
винты M3x6 (ISO 7380 или DIN 7985) | 11 | purchased | to-buy | усилитель (4), ножки полки (3), ножки корпуса (4); купить 15
винты M3x12 (ISO 7380 или DIN 7985) | 4 | purchased | to-buy | стяжка половин корпуса; купить 6
винты M3x8 (ISO 7380 или DIN 7985) | 23 | purchased | to-buy | спинка держателя (4), боковины к лотку (4), нижнее серво (4), верхнее серво (3), блок питания (4), подошва к крышке через шайбы (4); купить 30
винты M4x8 | 4 | purchased | to-buy | динамик во фланец; если отверстия во фланце Ø4,0, взять M3,5x8 и поправить пилот в стойках; купить 6
балласт 300-500 г | 1 | purchased | proposed | на дно корпуса, для устойчивости
