androsaurs/androsaur-stand/exports/androsaur-stand-assembly.step

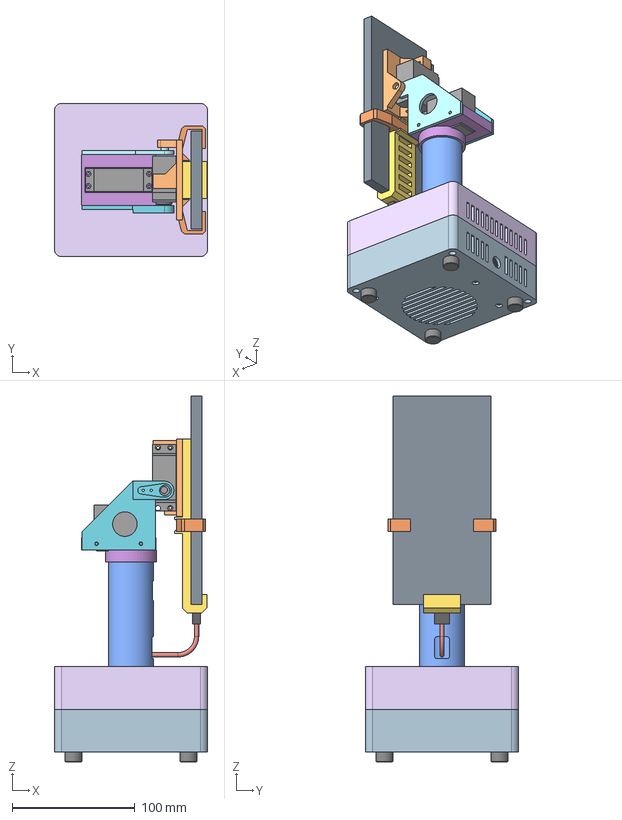
[picture p18: CAD file, 2026-11-04]
exports/androsaur-stand-assembly.step
125.0 x 125.0 x 298.5 mm
base
carrier
servo_pan
plate_horn
plate_shaft
platform
grip
phone
plug
cable
servo_tilt
box_lower
box_upper
shelf
esp32
amp
dac
psu
foot0
foot1
foot2
foot3
speaker
