androsaurs/androsaur-stand/exports/stl/shelf.stl

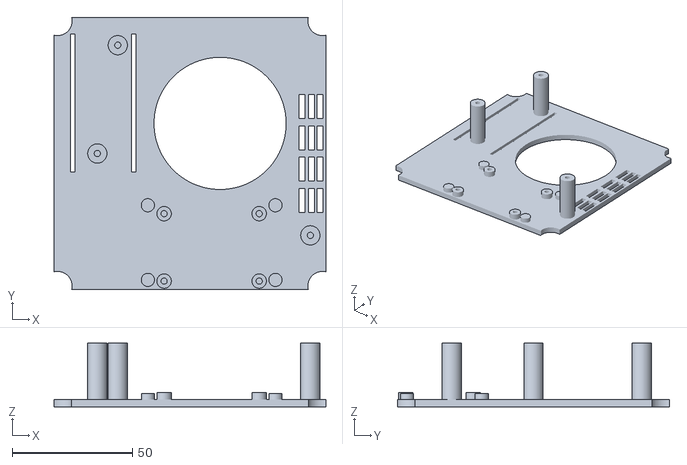
[picture p19: CAD file, 2026-11-11]
exports/stl/shelf.stl
113.0 x 113.0 x 26.5
