androsaurs/androsaur-stand/references/1941574-fresh-20261027/files/PanTiltBase_std.stl

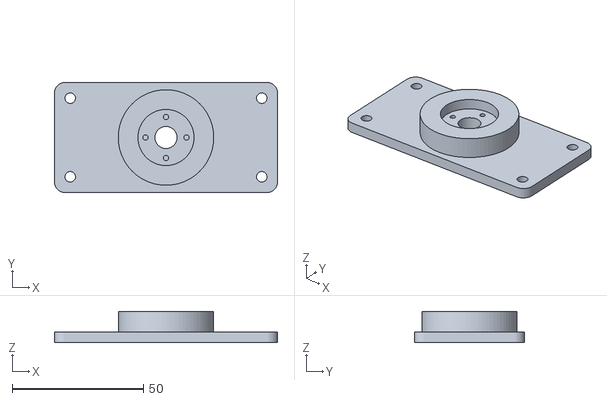
[picture p20: CAD file, 2026-11-02]
references/1941574-fresh-20261027/files/PanTiltBase_std.stl
85.0 x 42.0 x 12.0
