androsaurs/androsaur-stand/references/datasheets/mg996r/user-model/MG996R_Servo_Model.stl

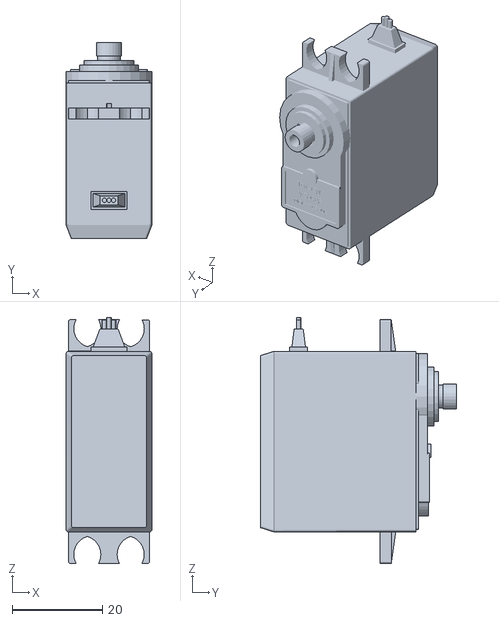
[picture p21: CAD file, 2026-10-26]
references/datasheets/mg996r/user-model/MG996R_Servo_Model.stl
19.0 x 43.5 x 54.5
