androsaurs/androsaur-stand/references/phone-holder-two-piece/Body.stl

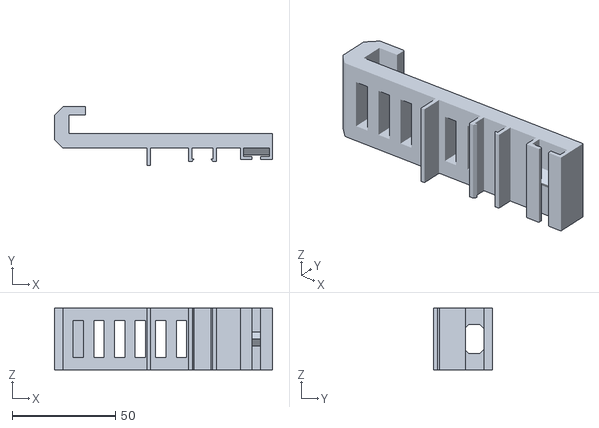
[picture p22: CAD file, 2026-11-02]
references/phone-holder-two-piece/Body.stl
105.6 x 28.5 x 30.0
