androsaurs/androsaur-stand/exports/stl/body_grip.stl

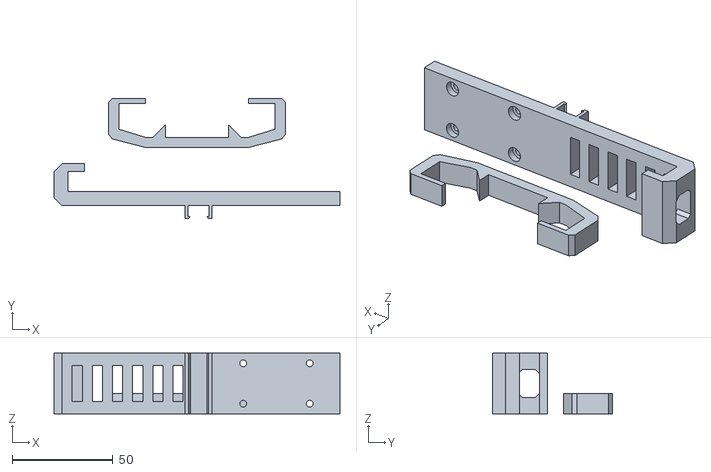
[picture p23: CAD file, 2026-11-11]
exports/stl/body_grip.stl
141.8 x 59.7 x 30.0
