androsaurs/androsaur-stand/references/1941574-fresh-20261027/files/PanMount7.stl

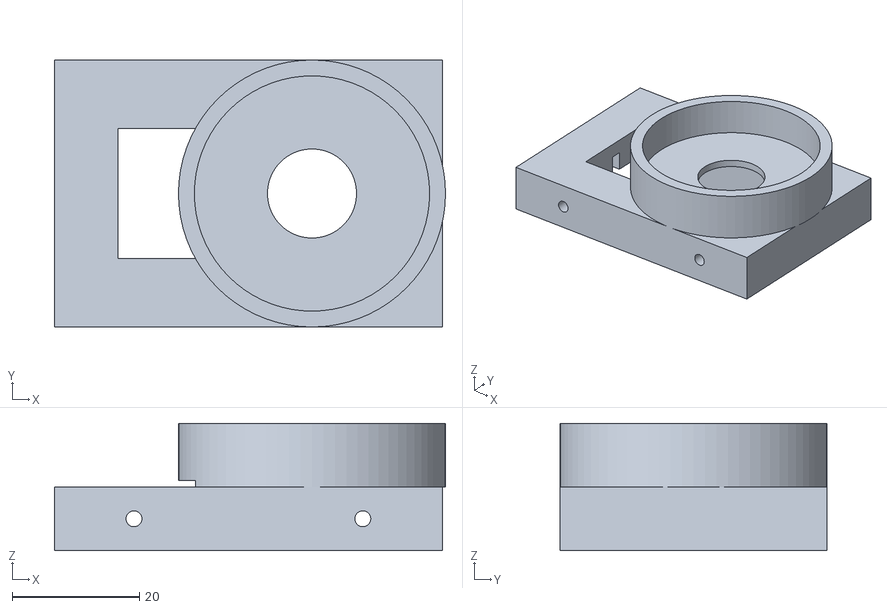
[picture p24: CAD file, 2026-11-02]
references/1941574-fresh-20261027/files/PanMount7.stl
61.5 x 42.0 x 20.0
