androsaurs/androsaur-stand/references/phone-holder-two-piece/82mm.stl

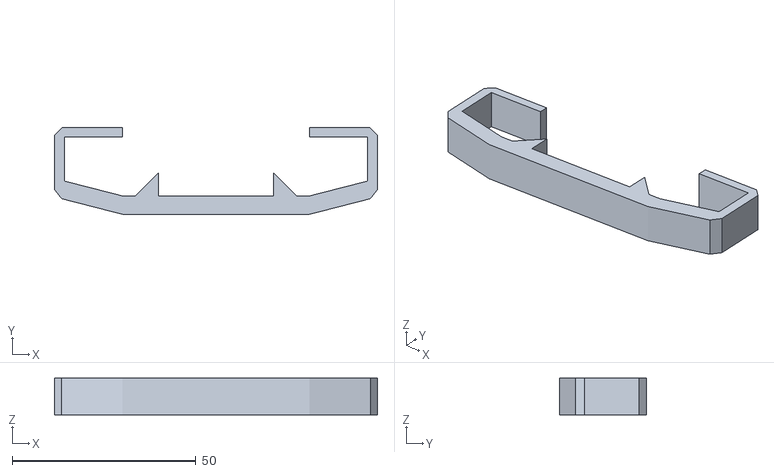
[picture p25: CAD file, 2026-11-02]
references/phone-holder-two-piece/82mm.stl
88.0 x 23.6 x 10.0
