androsaurs/androsaur-stand/references/1941574-fresh-20261027/files/IRTmount_pantilt.stl

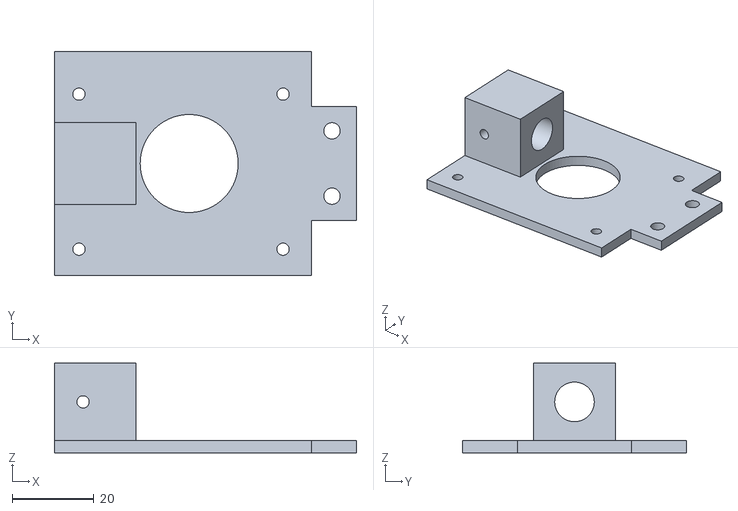
[picture p26: CAD file, 2026-11-02]
references/1941574-fresh-20261027/files/IRTmount_pantilt.stl
74.0 x 55.0 x 22.0
