androsaurs/androsaur-stand/exports/stl/base.stl

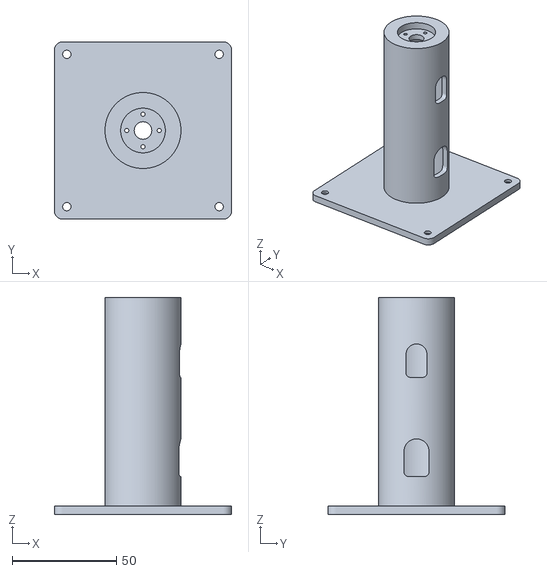
[picture p27: CAD file, 2026-11-11]
exports/stl/base.stl
85.0 x 85.0 x 104.0
