androsaurs/androsaur-stand/references/1941574-fresh-20261027/files/tiltservomount_std.stl

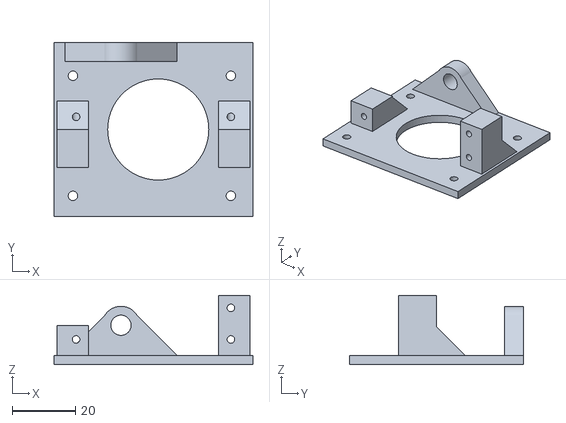
[picture p28: CAD file, 2026-11-02]
references/1941574-fresh-20261027/files/tiltservomount_std.stl
63.0 x 55.0 x 22.0
