androsaurs/androsaur-stand/exports/stl/box_lower.stl

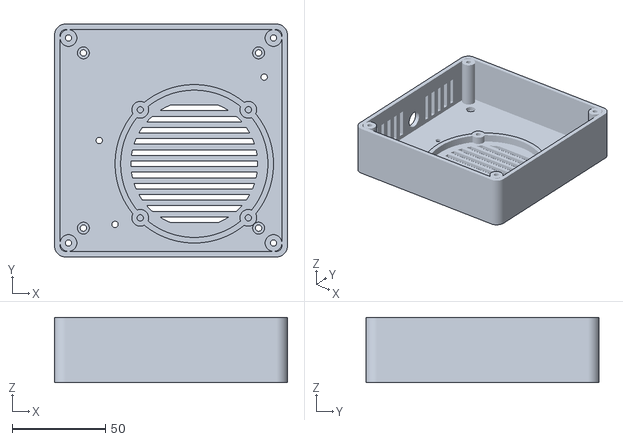
[picture p29: CAD file, 2026-11-11]
exports/stl/box_lower.stl
125.0 x 125.0 x 35.0
