androsaurs/androsaur-stand/references/1941574-fresh-20261027/files/sideplateservo_std.stl

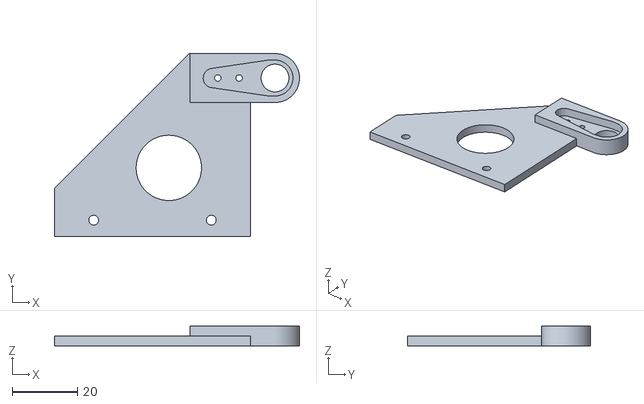
[picture p30: CAD file, 2026-11-02]
references/1941574-fresh-20261027/files/sideplateservo_std.stl
75.0 x 56.0 x 6.00
