androsaurs/androsaur-stand/exports/stl/box_upper.stl

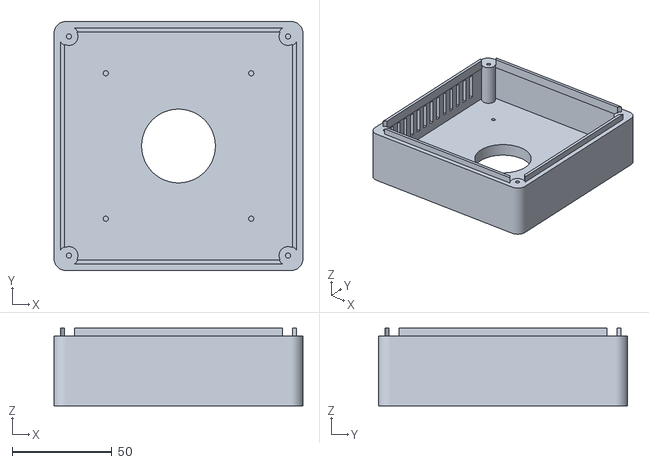
[picture p31: CAD file, 2026-11-11]
exports/stl/box_upper.stl
125.0 x 125.0 x 39.0
