androsaurs/androsaur-stand/references/1941574-fresh-20261027/files/sideplateshaft_std.stl

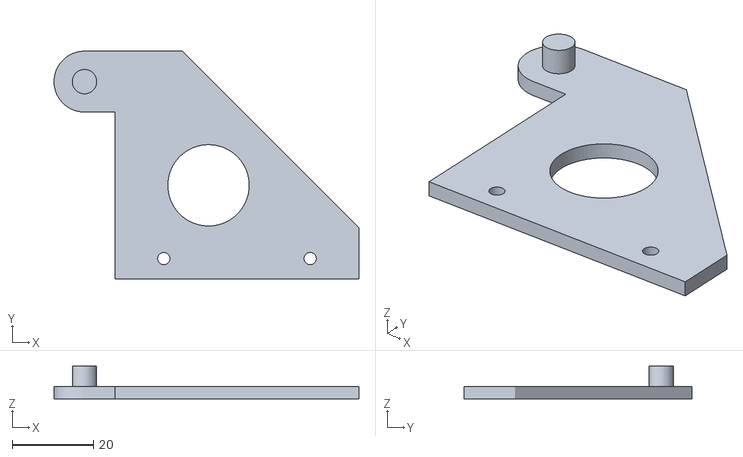
[picture p32: CAD file, 2026-11-02]
references/1941574-fresh-20261027/files/sideplateshaft_std.stl
75.0 x 56.0 x 8.00
