androsaurs/androsaur-stand/exports/stl/platform.stl

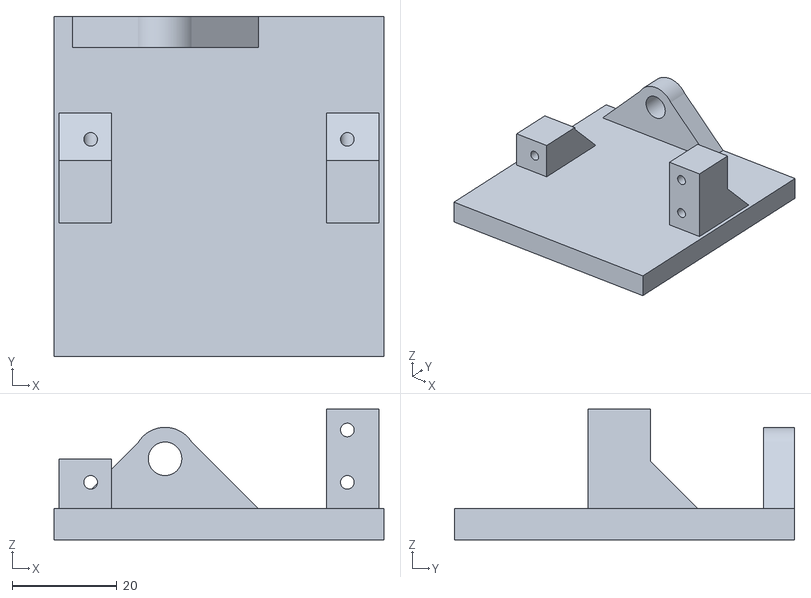
[picture p33: CAD file, 2026-11-08]
exports/stl/platform.stl
63.0 x 65.0 x 25.0
