androsaurs/androsaur-stand/exports/stl/grip.stl

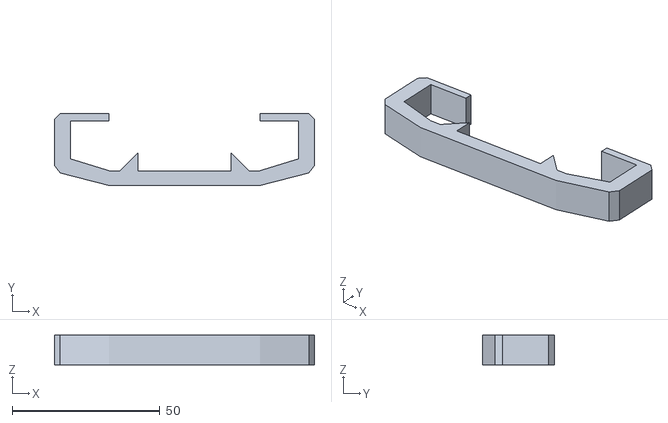
[picture p34: CAD file, 2026-11-08]
exports/stl/grip.stl
88.0 x 24.4 x 10.0
