androsaurs/androsaur-stand/exports/stl/body.stl

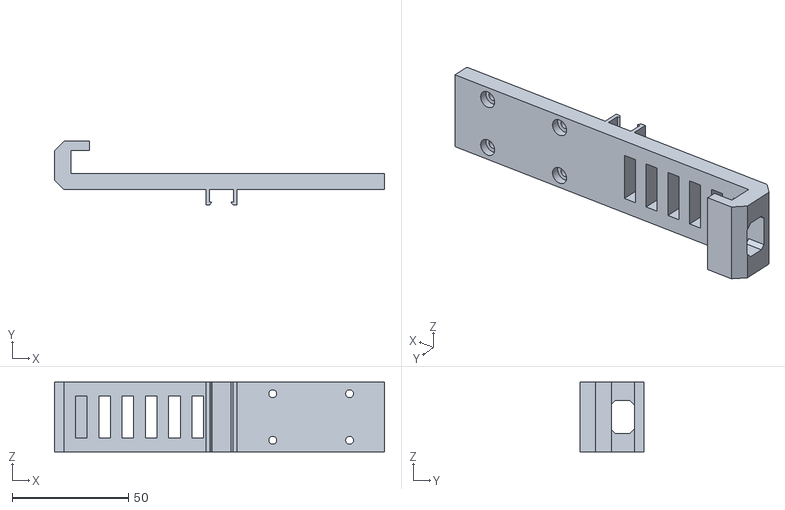
[picture p35: CAD file, 2026-11-08]
exports/stl/body.stl
141.8 x 27.3 x 30.0
