androsaurs/androsaur-stand/(list of files, cad)

Other CAD files:
exports/stl/plate_shaft.stl
exports/stl/carrier.stl
exports/stl/plate_horn.stl
references/1941574-fresh-20261027/scad/sideplateservo_std.scad
references/1941574-fresh-20261027/scad/tiltservomount_std.scad
references/1941574-fresh-20261027/scad/IRTmount_pantilt.scad
references/1941574-fresh-20261027/scad/PanMount7.scad
exports/androsaur-stand-assembly.FCStd
exports/stl/stand_washer.stl
references/1941574-fresh-20261027/scad/PanTiltBase_std.scad
references/1941574-fresh-20261027/scad/sideplateshaft_std.scad
references/pan-tilt-1941574/scad-rev/PanMount7.scad
references/pan-tilt-1941574/scad-rev/PanTiltBase_std.scad
references/pan-tilt-1941574/scad-rev/sideplateservo_std.scad
references/pan-tilt-1941574/scad-rev/sideplateshaft_std.scad
references/pan-tilt-1941574/scad-rev/tiltservomount_std.scad
