androsaurs/androsaur-stand/docs/printing.md

# Печать деталей

STL для слайсера лежат в [`exports/stl/`](../exports/stl/), по одному файлу на деталь. Получить заново после правки модели:

```bash
cd cadpy && .venv/bin/python export_stl.py
```

Скрипт кладёт каждую деталь в положение для печати (плоской гранью на стол, угол в нуле), сам пишет сводку и перечитывает
записанный STL: замкнут ли он и совпадает ли объём с CAD. Ориентация и свесы получены расчётом (грани круче 45° не на столе), а не пробной
печатью; печаталась только `plate_shaft` (первая проба), остальное ещё нет.

## Детали механизма и держателя

| Файл | Деталь | Габарит X × Y × Z, мм | Объём | Опора на стол | Свесы | Примечание |
| --- | --- | --- | --- | --- | --- | --- |
| `base.stl` | основание: подошва 85 × 85 и ножка | 85 × 85 × 104 | 59,3 см³ | 6360 мм² | 797 мм² | подошвой вниз; потолок полости Ø30 и крыши окон ножки: мост и острые верха, см. ниже |
| `carrier.stl` | лоток нижнего серво | 61,5 × 42 × 20 | 20,9 см³ | 1440 мм² | 848 мм² | плитой вниз, чашей вверх; карман серво 20,4 × 31 мм закрыт мембраной: мост |
| `plate_horn.stl` | боковина со стороны качалки | 75 × 56 × 6 | 7,7 см³ | 2321 мм² | 0 | плашмя; карман рычага серво сверху |
| `plate_shaft.stl` | боковина с выступом | 75 × 56 × 8 | 7,0 см³ | 2288 мм² | 0 | плашмя; хвостовик Ø6 вверх |
| `platform.stl` | площадка наклона | 63 × 65 × 25 | 30,1 см³ | 4074 мм² | 140 мм² | стороной под держатель вниз, рёбра вверх; под винты держателя глухие пилоты Ø2,6 от стола |
| `body.stl` | спинка держателя | 141,8 × 27,3 × 30 | 28,5 см³ | 1126 мм² | 397 мм² | на боку, профилем на стол; окна в плите вертикальные, отверстия под винты и вырез под штекер горизонтальные (мелкие мосты) |
| `grip.stl` | захват под телефон | 88 × 24,4 × 10 | 7,1 см³ | 709 мм² | 0 | на боку, профилем на стол; слои идут вдоль «рук» скобы |
| `stand_washer.stl` | прижимная шайба подставки, 4 шт. | 18 × 18 × 3 | 0,7 см³ | 245 мм² | 0 | плоской стороной вниз, выборкой Ø9,8 × 0,5 вверх; без поддержек |

Каждой детали по одной, кроме `stand_washer` — их четыре. Сборка и крепёж: [`fasteners.md`](fasteners.md); корпус электроники (`box_lower`, `box_upper`, `shelf`, ножки)
сюда не входит, положение для него в [`enclosure.md`](enclosure.md#печать-без-поддержек).

## G-code для Ghost6 (PLA)

Принтер Flying Bear Ghost6, только PLA, сопло 0,4 мм, слой 0,20 мм. G-code нарезан консольным OrcaSlicer инструментом
`slice.py` из проекта Ghost6 (`/mnt/fastdata/hram/projects/Ghost6`, описание в его `docs/slicing.md`) и лежит в [`exports/gcode/`](../exports/gcode/) (в git не идёт).

**Единый профиль печати (решение владельца 2026-11-08), одинаков для всех деталей:** 3 стенки, заполнение 15% узором **grid** (сетка),
3 нижних и 3 верхних слоя, сопло **210 °C**, стол 60 °C, без поддержек (кроме `carrier`). Профиль снят с G-code первой детали (`plate_shaft`); в нём сопло
220 °C и узор `crosshatch`, поэтому при нарезке добавляются `--set nozzle_temperature=210 --set nozzle_temperature_initial_layer=210 --set sparse_infill_pattern=grid`.
Исключения: `plate_shaft` (напечатана раньше) и `plate_horn` (печаталась с `crosshatch`, оставлена по решению владельца) имеют узор crosshatch. Других `--set` (стенки,
заполнение) без слова владельца не использовать.

**Brim (брим, кайма), решение владельца 2026-11-10:** по умолчанию выключен.
Всегда добавлять к команде нарезки `--set brim_type=no_brim --set brim_width=0`,
поскольку исходный профиль включает `auto_brim`. Включать кайму только после явного
согласования владельца. Предлагать её только для маленьких, тонких или неустойчивых
деталей с малой опорой на стол; для широких устойчивых деталей не предлагать.
После нарезки проверять отсутствие `;TYPE:Brim` в G-code. Исторические G-code в таблице
ниже нарезаны до этого решения и могут содержать кайму.

| G-code | Слоёв | Время (оценка) | PLA | Мосты и свесы |
| --- | --- | --- | --- | --- |
| `grip_PLA_23m27s.gcode` | 50 | 23 мин | 5,6 г | нет |
| `body_PLA_1h44m34s.gcode` | 150 | 1 ч 45 мин | 21,4 г | шесть окон в плите: потолок по 5 мм; вырез под штекер |
| `plate_horn_PLA_22m16s.gcode` | 30 | 22 мин | 5,8 г | нет |
| `platform_PLA_58m58s.gcode` | 125 | 59 мин | 15,3 г | мелкие свесы (140 мм²) |
| `carrier_PLA_1h4m6s.gcode` | 126 | 1 ч 04 мин | 16,1 г | **с поддержками** (normal auto): без них мембрана кармана серво 20 × 31 мм не напечаталась |
| `base_PLA_2h54m5s.gcode` | 520 | 2 ч 54 мин | 48,3 г | свод полости (конус от z = 84), окна со сводом вверху, без поддержек |
| `plate_shaft_PLA_19m15s.gcode` | 40 | 19 мин | 5,1 г | нет (уже напечатана; сопло было 220 °C) |

Итого около 115 г PLA и 7,5 часов чистого времени. Оценки времени из слайсера, не измеренное время печати. Все файлы проверены: в области
стола 255 × 210 мм, в начале нагрев 60/210 °C, в конце выключение нагрева. Поддержек нет, кроме `carrier`.

Заново нарезать всё после правки модели (абсолютные пути; `export_stl.py` сначала):

```bash
S=$PWD/exports/stl; O=$PWD/exports/gcode; T=/mnt/fastdata/hram/projects/Ghost6/slice.py
python3 $T slice $S/grip.stl $S/body.stl $S/plate_horn.stl $S/platform.stl $S/carrier.stl $S/base.stl \
  --set nozzle_temperature=210 --set nozzle_temperature_initial_layer=210 --set sparse_infill_pattern=grid \
  --set brim_type=no_brim --set brim_width=0 --out $O
# carrier только с поддержками (без них мост 20 × 31 мм не печатается)
python3 $T slice $S/carrier.stl --set nozzle_temperature=210 --set nozzle_temperature_initial_layer=210 \
  --set sparse_infill_pattern=grid --set enable_support=1 --set brim_type=no_brim --set brim_width=0 --out $O
```

Тонкие детали, на которые, возможно, придётся поднять число стенок или заполнение (PLA под нагрузкой около греющегося серво ползёт),
например стенка кармана рычага `plate_horn`: решает владелец после пробной печати.

## Мосты: учимся на печати

Принтер, по словам владельца, небольшие мосты печатает. Здесь они такие (по расчёту свесов, не по пробе):

| Деталь | Мост | Что это |
| --- | --- | --- |
| `body` | 5 мм, шесть штук | потолки окон в плите; плюс горизонтальные отверстия под винты и вырез под штекер |
| `platform` | мелкие | наклонные грани и перемычки (140 мм²) |
| `carrier` | 20 × 31 мм | мембрана над карманом серво: самый заметный мост |
| `base` | 31 мм (был) | потолок полости Ø30 в ножке; заменён коническим сводом от z = 84 (см. «Тест свода `base`»), в `base.stl` ещё плоский |

Порядок, чтобы наращивать длину моста по ходу: `grip` (без мостов, проверка посадки) → `body` (мосты 5 мм) → `plate_horn` → `platform` →
`carrier` (20–31 мм) → `base` (31 мм, последним, 2,5 часа и 52 г). Если мост провисает: сначала охлаждение и скорость мостов в профиле, потом
форма (конус вместо плоского потолка в `base`), поддержки только в последнюю очередь. Результат каждой пробы записывать здесь.

### Тест свода `base`

Плоский потолок полости над кругом Ø30,4 мм (мост 31 мм) заменён **коническим сводом**: от z = 84 мм (`CONE_Z0` в `pantilt.py`) полость
сужается до отверстия под кабель Ø8,4 мм на z = 97 мм (13 мм высоты, около 40° от вертикали). Каждый слой лежит на предыдущем с небольшим
выступом, принтер строит свод сам, без моста и без поддержек. Окно «motors» (до z = 81,75) и всё выше z = 97 не двигались.

Перед печатью всего `base` (2,5 часа, 48 г) печатается верхняя часть `base_top` (`exports/test/base_top.stl`, G-code
`exports/gcode/base_top_PLA_35m26s.gcode`): 36,4 × 36,4 × 22 мм, 35 мин, 8,9 г. Это та же геометрия `base()`, срезанная на z = 82 мм: 2 мм
цилиндрической полости, затем свод, гнездо и четыре отверстия Ø2 мм (сквозные: от верхней грани до полости). Профиль тот же (3 стенки, 15% grid, 210/60 °C), **без поддержек**.
Строится командой `cadpy/.venv/bin/python cadpy/export_bridge_test.py [--cut-z 82]`.

В G-code нет блока `Bridge`; остаются два небольших `Overhang wall` (места, где сквозные отверстия Ø2 пересекают конус) и внутренние мосты над заполнением.
Проверено по модели: кабель и основание не пересекаются с остальными деталями при наклоне 0°, 45°, 90°.

Что смотреть при печати: ровно ли ложатся слои свода, нет ли «бахромы» на внутренней поверхности конуса (последние 3–4 мм перед отверстием). Если свод
напечатался, `base` печатается без поддержек. Результат записать в `notes/stand-build-log.md` пространства.

Верх окон «зарядка» и «motors» тоже сделан полукруглым (дуга R6 и R5 при той же высоте окна), чтобы не было мостов 10–12 мм. `base.stl` и `base_PLA_2h54m5s.gcode` выгружены и нарезаны уже с конусом, сквозными отверстиями и арочными окнами; в G-code остаются однослойные `Bridge` на вершинах арок (пролёт 1–3 мм) и маленькие свесы.

## Что печатать сначала

1. **`grip` и `body`**: быстро и дёшево, и сразу видно, садится ли телефон. Зазор 0,5 мм по бокам и 0,8 мм по толщине
   (`FIT_SIDE`, `FIT_THICK` в `clip_holder.py`) прикидочный: принтеры по-разному печатают пазы. Телефон должен входить свободно
   без люфта; если тугой, увеличить зазор, выгрузить STL и нарезать заново.
2. **`plate_horn`**: проверить посадку серво и рычага.
3. **`platform`, `carrier`, `base`** в этом порядке.

## Настройки

PLA, сопло 0,4, слой 0,2, без поддержек. Профиль и способ его воспроизведения: `docs/slicing.md` в проекте Ghost6.
Печатать плашмя, как лежат STL: слои тогда идут вдоль плиты и нагрузка идёт вдоль слоёв.
