androsaurs/androsaur-stand/docs/verification.md

# Проверки

Всё проверено скриптами в `cadpy/` на геометрии в BRep. Ничего из этого не заменяет пробную печать и проверку реального железа.

## Пересечения

`check.py -2 45 90 100` перебирает все пары деталей сборки при наклонах −2°, 45°, 90°, 100° (поворот 0°). **Пересечений нет.**
`pancheck.py`: наклон 0°/45°/90° × поворот 45°/90°/135°/180° — без пересечений.

Свободный ход наклона по модели: примерно от −2° до 101°: нижний предел задаёт касание серво друг с другом (толщина серво 20 мм), верхний касание кабеля с основанием; он не зависит
от высоты ножки.

## Зазоры (текущая компоновка)

| Пара | Зазор |
| --- | --- |
| Кабель телефона — крышка корпуса при наклоне 90–100° | 7,6 мм |
| Телефон — верхняя половина | не менее 47 мм |
| Динамик (конус) — край отверстия полки | 1,5 мм |
| Усилитель — динамик (конденсаторы над фланцем, зазор по высоте) | 0,9 мм |
| Усилитель — стенка нижней половины (+Y) | 3,0 мм |
| Усилитель — штыри ESP32 | 17,6 мм |
| ESP32 — верхняя половина (юбка) | 0,7 мм |
| Блок-заглушка — подошва подставки | 1,5 мм |
| Блок-заглушка — динамик (магнит) | 1,5–5 мм |

## Устойчивость

Метод: центр масс всей сборки по объёмам деталей в CAD и массам из оценок, проекция центра на многоугольник опоры (четыре ножки
Ø14 в точках (±47; ±47), края ножек на ±54 мм от центра), для разных поз.

Допущения масс: пластик 1,24 г/см³ при заполнении 50% (при 100% устойчивее), серво 55 г × 2, динамик 200 г, ESP32 10 г, усилитель 25 г,
блок питания 45 г, штекер с кабелем 15 г, телефон 200 или 300 г. Провода, зарядка и предохранитель не учтены.

| Телефон | Поза (наклон / поворот) | Масса | Центр масс от центра, мм | Запас до края опоры, мм | Наклон стола до опрокидывания |
| --- | --- | --- | --- | --- | --- |
| 200 г | 45° / 0° | 0,89 кг | 19,5 вперёд | 34,5 | 15,9° |
| 200 г | 100° / 0° | 0,89 кг | 18,2 вперёд | 35,8 | 17,4° |
| 200 г | 100° / 90° | 0,89 кг | 14,7 в бок | 39,3 | 19,0° |
| 200 г | 100° / 180° | 0,89 кг | 11,4 назад | 42,6 | 20,5° |
| 300 г | 45° / 0° | 0,99 кг | 22,7 вперёд | 31,3 | 13,3° |
| 300 г | 100° / 0° | 0,99 кг | 21,6 вперёд | 32,4 | 14,7° |
| 300 г | 100° / 90° | 0,99 кг | 18,5 в бок | 35,5 | 16,0° |
| 300 г | 100° / 180° | 0,99 кг | 15,4 назад | 38,6 | 17,3° |

Вывод: статически устройство стоит на любой позе, центр масс внутри опоры. Но опрокидывающая сила на верх телефона
(около 250 мм от стола) всего **1,2–1,5 Н** (120–150 гс), лёгкий толчок рукой может её завалить. Рекомендации:

- балласт 300–500 г на дно корпуса (даёт примерно +70% к опрокидывающей силе);
- переставить тяжёлое (динамик, блок питания) в заднюю половину корпуса: сейчас динамик в переднем углу и сдвигает центр масс вперёд;
- резиновые накладки на ножки.

## Печатаемость без поддержек

Проверялась расчётом свесов больше 45° для каждой ориентации детали и мостов (до 8 мм допустимо, до 15 мм на пределе).

| Деталь | Ориентация | Результат |
| --- | --- | --- |
| `box_lower` | дном вниз | свесов нет |
| `box_upper` | потолком вниз | свесов нет (юбка и ступенька — вверх) |
| `shelf` | плитой вниз | верх плоский, остальное вверх |
| подошва и ножка `base` | подошвой вниз | потолок полости Ø30 и крыши окон — мост; **нужно решить**: конус в потолке и острые верхи окон |
| `carrier` | плитой вниз, чашей вверх | мембрана кармана серво 20,4 × 31 мм — мост |
| остальные детали механизма и держателя | см. расчёт | без поддержек |

Расчёт делался до добавления корпуса; детали корпуса проверены отдельно (поддон — свесов нет; крышка и полка — только мелкие мосты
цековок и полочек юбки).

## Известные ограничения проверок

- Массы оценочные, провода не учтены, динамические нагрузки (разгон серво, толчок) не считались.
- Размеры плат — оценки по фото (кроме габаритов), блок питания — заглушка.
- Модель серво — габарит; точные посадки и отверстия не проверены.
