androsaurs/androsaur-stand/docs/open-issues.md

# Открытые вопросы и риски

Ранжировано по важности. Отмечено, что решает владелец.

## Блокирует работающее устройство

1. **Блок питания куплен, но чип не подтверждён.** В описании «XL4016E1, 4–38 В, 1,25–37 В, 8 А», на фото HW-674 (XL4005) 60 × 38 × 26.
   В модели макет по фото, поставлен на полку на втулках с четырьмя винтами; положение компонентов и отверстий оценочное. Если придёт
   большая плата XL4016 (65 × 47 × 23,5), она в это место не влезает по ширине (свободно около 42 мм по Y). Проверить размер,
   отверстия и маркировку чипа по приходе. Реальный ток XL4005 около 3–4 А, а два MG996R при упоре берут до 5 А.
2. **USB ESP32 внутри закрытого корпуса.** Прошивать только со снятой верхней половиной. Нужно окно в стенке или удлинитель USB.
3. **Кабель блока питания → полка.** Гнездо питания на задней стенке под полкой, блок питания на полке над ней: проход
   для проводов через полку или щель между полкой и стенкой (3 мм) не сделан.
4. **Нет проводки.** Нет проходов под провода серво к ESP32, крепления конденсатора и предохранителя, разъёмов серво.

## Влияет на надёжность

5. **Устойчивость с телефоном** ([verification.md](verification.md)): опрокидывающая сила на верх телефона около 1,2–1,7 Н.
   Нужен балласт 300–500 г на дне и/или ножки шире.
6. **Винты M3×6 самонарезом в слепые отверстия 2,6 мм** (крышка 8 мм, стойки, ножки) — для эксперимента, для постоянной работы
   латунные резьбовые вставки. Крепёж: [fasteners.md](fasteners.md); не определены крепление боковин механизма к лотку, блок питания
   и диаметр отверстий во фланце динамика (M4 или M3,5).
7. **Зазоры тесные:** усилитель до динамика 0,9 мм (конденсаторы над фланцем, зазор по высоте) и до стенки 3,0 мм; блок питания до подошвы подставки 1,5 мм;
   кабель телефона при наклоне 90–100° подходит к корпусу на 7,6 мм.
8. **Вентиляция** оценена по площади щелей, не расчётом: полка 300 мм², задние стенки 660 мм² и больше. Нагрев усилителя и
   блока питания внутри закрытого корпуса не измерялся.
9. **Антенна ESP32** у стенки корпуса рядом с усилителем и блоком питания; помехи не проверялись.
10. **Кольцо под динамиком** (по окружности болтов, радиус 39,5–42,5) касается фланца без зазора, но без прокладки герметичность не гарантирована: нужен поролон 1–2 мм.
11. **Передний правый угол полки без ножки:** там динамик, опоры нет; на этом участке на полке ничего не стоит.

## Допущения, которые надо измерить

- Диаметр окружности отверстий динамика (принят Ø82) и размеры фланца (толщина 2,5 принята).
- Высоты компонентов и крепёжные отверстия усилителя, ЦАП и ESP32 (оценки по фото; у ЦАП креплений нет).
- Реальная высота модуля блока питания; масса динамика, платы, телефона (200–300 г принято).
- Диаметр резьбы панельного гнезда питания: Ø7,6 по замеру владельца, по чертежу M8×0,75 (номинал 8,0); отверстие Ø8,0. Если резьба на деле ближе к 8,0, Ø8,0 будет тугим (FDM даёт отверстие меньше) — взять около 8,4. Не проверено на отпечатке: если резьба не входит, увеличить `JACK_HOLE_D` в `cadpy/enclosure.py`.
- Серво MG996R — габарит по STL владельца, не обмеренный экземпляр. Положение отверстий — номинальная схема.

## Не сделано вообще

Прошивка, пробная печать (Flying Bear Ghost6, PLA), проверка шлицев и качалок, удержание телефона, нагрузки на ножку.
Проверка печатаемости выполнялась расчётом свесов по ориентациям, а не пробной печатью.
