androsaurs/androsaur-stand/docs/schematic-print.pdf

## Androsaur Stand — монтажная схема · 14.11.2026

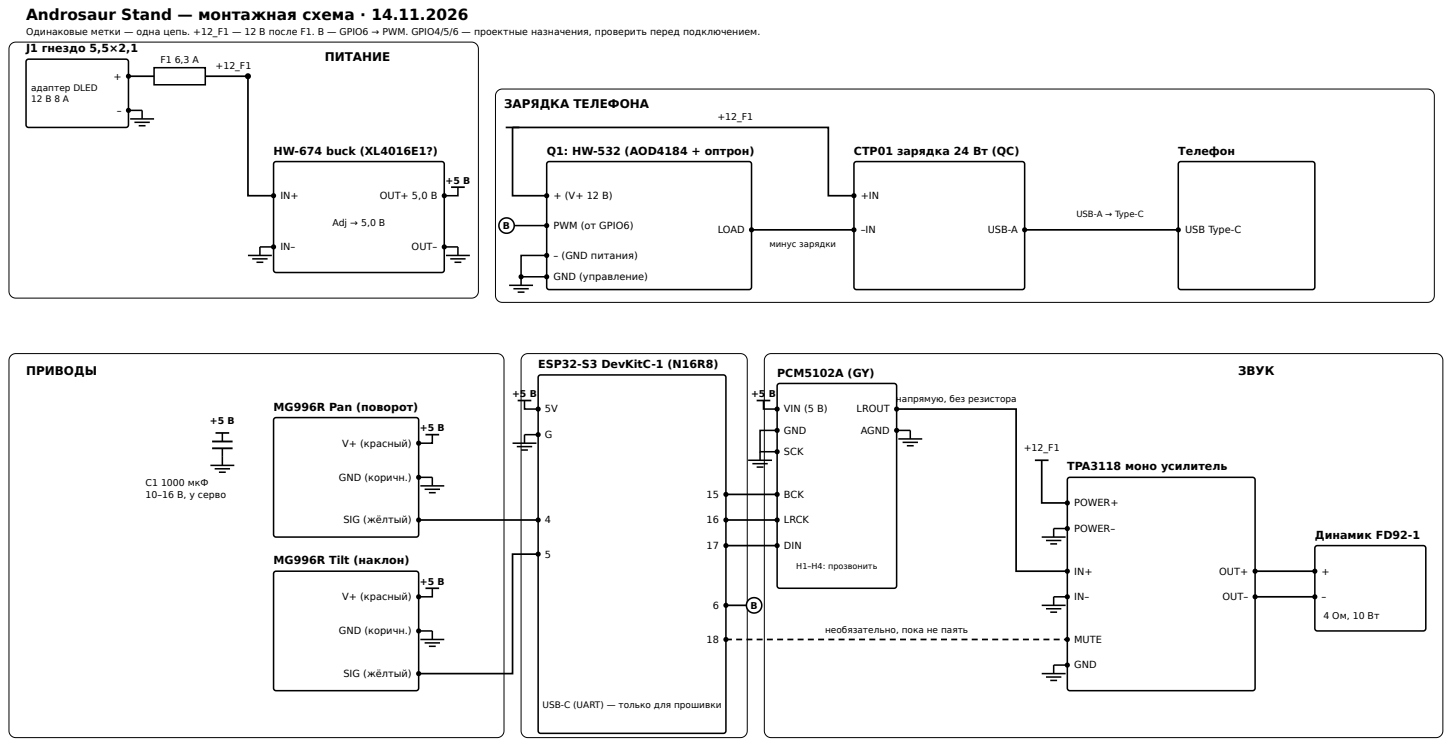
[picture p36: page 1]
ПИТАНИЕ; ЗАРЯДКА ТЕЛЕФОНА; ПРИВОДЫ; ЗВУК; адаптер DLED 12 В 8 А; HW-674 buck (XL4016E1?); OUT+ 5,0 В; OUT–; Adj → 5,0 В; USB-A; Телефон; USB Type-C; USB-A → Type-C; C1 1000 мкФ 10–16 В, у серво; MG996R Pan (поворот); V+ (красный); GND (коричн.); SIG (жёлтый); MG996R Tilt (наклон); ESP32-S3 DevKitC-1 (N16R8); PCM5102A (GY); VIN (5 В); GND; SCK; BCK; LRCK; DIN; LROUT; AGND; H1–H4: прозвонить; Q1: HW-532 (AOD4184 + оптрон); LOAD; минус зарядки; B PWM (от GPIO6); – (GND питания); GND (управление)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

Одинаковые метки — одна цепь. +12_F1 — 12 В после F1. B — GPIO6 → PWM. GPIO4/5/6 — проектные назначения, проверить перед подключением.
J1 гнездо 5,5×2,1

CTP01 зарядка 24 Вт (QC)

напрямую, без резистора

необязательно, пока не паять

USB-C (UART) — только для прошивки
