androsaurs/androsaur-stand/(commit log)

2026-10-25 Add parametric servo reference model for stand design
    [servo-352944.FCStd, servo-352944.step]
2026-10-25 Build complete stand mockup with linked assemblies and project documentation
    [base-bottom.FCStd, base-bottom.step, base-bottom.stl, base-cover.FCStd, base-cover.step, base-cover.stl, base-shell.FCStd, base-shell.step]
2026-10-25 Document prototype requirements and archive original reference drawings
2026-10-26 Preserve assembled MG996R pan-tilt baseline
    [IRTmount_pantilt.scad, IRTmount_pantilt.stl, MG996R_Servo_Model.stl, PanMount7.scad, PanMount7.stl, PanTiltBase_std.scad, PanTiltBase_std.stl, assembly-user-mg996r.FCStd]
2026-10-26 Add phone holder and taller hollow base with cable ports
    [assembly-user-mg996r.FCStd, axle-support.FCStd, base-hollow.FCStd, base-hollow.step, base-hollow.stl, base-raised.FCStd, base-raised.stl, base-round-horn.FCStd]
2026-10-26 Checkpoint CAD workspace before modular cleanup
    [assembly-user-mg996r.FCStd, assembly.FCStd, base-hollow.FCStd, base-hollow.step, base-hollow.stl, base.FCStd, base.step, base.stl]
2026-10-26 Organize stand into linked CAD modules and remove obsolete work
    [IRTmount_pantilt.scad, IRTmount_pantilt.stl, assembly-user-mg996r.FCStd, assembly.FCStd, axle-support.FCStd, axle-support.stl, base-bottom.FCStd, base-bottom.step]
2026-10-26 Save current modular CAD documents
    [base.FCStd, mg996r.FCStd, pan-carrier.FCStd, pan-horn.FCStd, pan-tilt.FCStd, phone-holder.FCStd, phone.FCStd, servo-side.FCStd]
2026-10-26 Replace faceted base riser with smooth cylinder and refresh preview
    [base.FCStd, base.step, base.stl, pan-tilt.FCStd, stand.FCStd]
2026-11-02 Replace mesh pan-tilt mechanism with BRep modules and a BRep MG996R envelope
    - Add BRep parts built from the micromet SCAD sources: pan-carrier, servo-side,
    shaft-side, tilt-platform (servo mount blocks shifted 1.3151 mm for MG996R).
    - Add components/mg996r-brep, a BRep envelope measured from the user's MG996R mesh.
    - Add assemblies/pan-tilt-brep.FCStd; stand.FCStd now links it, placements unchanged.
    - Remove pan-tilt.FCStd and the mesh parts with their exports.
    - Add build-brep-parts and build-mg996r-brep macros, update export-model macro.
    - Document the module, checks and open tray-ceiling overlap in docs/pan-tilt-brep.md;
    update BOM, README and the other docs; refresh exports and the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
    [IRTmount_pantilt.scad, IRTmount_pantilt.stl, PanMount7.scad, PanMount7.stl, PanTiltBase_std.scad, PanTiltBase_std.stl, base.step, bom.csv]
2026-11-02 Save re-saved CAD documents and the two-piece phone holder work in progress
    - Re-saved base, pan-horn, tilt-horn, phone-holder, phone, mg996r and the phone-holder assembly.
    - Add the two-piece phone holder (body and 82 mm grip), the adapter plate and the assembly
    phone-holder-two-piece.FCStd; it is not installed in stand.FCStd yet.
    - Add its source models in references/phone-holder-two-piece.
    [82mm.stl, Body.stl, base.FCStd, mg996r.FCStd, pan-horn.FCStd, phone-adapter-plate.FCStd, phone-grip-82mm.FCStd, phone-holder-body.FCStd]
2026-11-04 Save the two-piece phone holder BRep work in progress
    [phone-grip-82mm.FCStd, phone-holder-body.FCStd, phone-holder-two-piece.FCStd]
2026-11-04 Rebuild the pan-tilt stand and two-piece phone holder in build123d
    Parametric BRep model in cadpy/: hollow leg with two cable windows, pan carrier,
    side plates, tilt platform, MG996R envelopes, Body + 82mm clip holder, Type-C
    plug and pseudo cable. Includes collision sweeps over tilt and pan, renders and
    a live OCP viewer launcher.
2026-11-04 Add the electronics enclosure draft in build123d: two-half box with shelf, speaker, ESP32, amp, DAC and power module placeholders
    Enclosure 125x125x70 split horizontally (screws from below), stand base plate
    hung under the lid, FD92-1 speaker in a corner over a floor grille, shelf on
    three legs with flat top, DC inlet and vents in the rear walls, wide feet.
    Per-part colours in the viewer; module envelopes are estimates from photos.
2026-11-04 Rewrite the documentation for the build123d model, add screenshots and STEP export
    README, design, enclosure, electronics, verification, open issues, model guide, part names, interfaces, requirements and BOM
    now describe the cadpy model and the electronics enclosure. The FreeCAD-era documents are kept in docs/legacy-freecad.
    Add cadpy/export.py (coloured STEP for FreeCAD), cadpy/shots.py (documentation pictures in docs/img), cadpy/palette.py,
    the exported assembly STEP, and the latest enclosure changes (centred DC inlet, vents below the shelf, shelf airflow slots).
    [androsaur-stand-assembly.step, bom.csv]
2026-11-04 Reduce the fastener list to M3x6, M3x12 and M4x8 and document it; fix sealed voids in the lid posts
    Head recesses (D6.4 x 2.5) in the base plate underside and in the floor over the feet let M3x6 reach; the half-joining
    screws are M3x12 in a 31 mm tunnel in the lower posts. The corner posts of the upper half enclosed a sealed void above the
    ledge (STEP split it into extra solids), now filled. Add docs/fasteners.md, update BOM, README and enclosure docs, and
    regenerate the STEP plus add the FreeCAD project export of the assembly.
    [androsaur-stand-assembly.FCStd, androsaur-stand-assembly.step, bom.csv]
2026-11-04 Add fasteners to the model, speaker seal ring, thicker platform with nut-free holder screws
    hardware.py: simplified screws, nuts, washers; assemble(hw=True) places 38 fasteners (red, in their own group in the viewer,
    all parts shown translucent). Fasteners unified to M3x6, M3x8, M3x12 and M4x8: servo ears, side plates and holder spine use
    M3x8; the holder screws now go from the phone side into blind pilots of a 6 mm platform (MOUNT_PAD 3), so no nuts.
    Ring under the speaker flange on the bolt circle (3 mm wall) so the sound leaves only through the floor grille.
    Docs: fasteners, design, BOM and enclosure updated.
    [bom.csv]
2026-11-04 Add the buck module model with posts and spacers, symmetric amplifier layout, measured servo thickness 20 mm
    HW-674 buck module on the shelf top on printed 3 mm spacers (M3x8 from the top into the shelf and posts under it), amplifier
    components laid out symmetrically and the amplifier centred under the power module, servo body thickness 20 mm (measured),
    which narrows the free tilt range to -2..100 degrees. Docs: fasteners, BOM, electronics, open issues, verification, design.
    [bom.csv]
2026-11-04 Remove the old FreeCAD model, scripts, exports and archive docs
    The FreeCAD files (cad/, scripts/*.FCMacro, exports/assemblies, exports/parts, docs/legacy-freecad) are dropped from the
    working tree; the old state stays in git history (commit 9d254f3). Documentation and source comments now point to the
    commit instead of tags. The current model is the build123d code in cadpy/.
    [base.FCStd, base.step, base.stl, bom.csv, mg996r-brep.FCStd, mg996r.FCStd, mg996r.stl, pan-carrier-brep.FCStd]
2026-11-05 Share assembly grouping and colors across viewer and STEP export
2026-11-08 Update phone dimensions and holder, add STL export, print guide and PLA G-code instructions
    [base.stl, body.stl, carrier.stl, grip.stl, plate_horn.stl, plate_shaft.stl, platform.stl]
2026-11-08 Switch infill pattern to grid for remaining parts in printing guide
2026-11-11 Add electronics schematic and pre-solder checks checklist
2026-11-11 Save stand model, viewer and docs work in progress
    [base.stl, body_grip.stl, bom.csv, box_lower.stl, box_upper.stl, shelf.stl, stand_washer.stl]
2026-11-11 English README with Russian translation, jack hole D8.0, viewer fixes, jack drawing
    [bom.csv]
2026-11-12 Add ESP32 firmware with secure BLE setup and pinned HTTPS control
    [partitions.csv]
2026-11-13 stand: add battery and tracking support
2026-11-14 feat: add OTA, charger control and configurable smooth tracking
